glm02/projet-vide-cave/05_Notes/Obsidian/01 - Fonctionnement et architecture.md

---
tags: [vide-cave, architecture]
date: 2026-10-12
---
# Fonctionnement et architecture

Retour : [[00 - Accueil]] · Suite : [[04 - Anomalies et verifications]]

## Besoin prévu par les documents

La pré-étude prévoit la surveillance d'une pompe vide-cave, des informations de courant et de déphasage, un autotest tous les trois jours d'une durée maximale d'une minute, un affichage LCD et des alertes par LED/buzzer. Les seuils et les données de la plaque moteur sont à compléter.

## Chaîne prévue

```mermaid
flowchart LR
    AC[Alimentation secteur] --> P[Commutation de puissance par triac]
    P --> M[Moteur de pompe]
    M -. Courant à mesurer .-> I[Capteur de courant]
    I -. Signal analogique à relier .-> PIC[PIC16F1788]
    PIC -. Commande à raccorder .-> O[Optotriac]
    O --> P
    PIC --> LCD[LCD 162B]
    PIC -. Alarmes à terminer .-> A[LED et buzzer]
    V[Référence de tension ou zéro secteur à prévoir] -. Déphasage .-> PIC
```

Ce synoptique expose **l'intention**, pas une garantie que ces connexions sont présentes dans les fichiers actuels. Les pointillés signalent des interfaces à terminer ou à définir.

## Blocs présents dans le schéma G206

| Bloc | Rôle prévu | État à comprendre |
| --- | --- | --- |
| U1, PIC16F1788 | Acquisition, décision, affichage et commande | Firmware absent ; configuration de RA6/RA7 et des entrées analogiques à préciser |
| U3, symbole ACS756 | Mesure du courant moteur | Voie IP+/IP− non câblée ; sortie AN0 différente du net « capteur de courant » du PIC |
| TRIAC1, symbole FODM3011 / valeur « octo-triac » | Optotriac de commande vers la puissance | Référence réelle à choisir ; net de commande PIC différent de RB2 côté R7 ; empreinte actuellement hors carte |
| Triac_de_puissance1 | Commutation de la pompe | Référence fabricant et empreinte absentes ; pas encore sur le PCB |
| DS1, 162B | Affichage | Brochage particulier étudié ; ne pas lui appliquer automatiquement celui d'un LCD générique |
| BZ1 | Alerte sonore | Empreinte absente, polarité à clarifier |
| M1 | Moteur de la pompe, externe | Plaque moteur et raccordement à représenter ; n'a pas à être implanté comme un composant sur le PCB |
| Alimentation / reset / ICSP | Alimentation et programmation du PIC | Base nominale identifiée ; découplage physique à revoir |

La carte ne dispose pas de voie tension ou de détection du zéro permettant de produire la mesure de déphasage décrite dans la pré-étude. Le symbole AC n'est pas un bornier secteur phase/neutre complet.

## Limites de lecture

Les valeurs « 230 V », « environ 300 W » ou « 5 A » présentes dans la variante sont des hypothèses historiques, pas des mesures confirmées de cette pompe. Les choix de triac, optotriac, isolement et protections nécessitent les données réelles. Le [rapport d'analyse](../Analyse_G206_2026-10-12/RAPPORT_ANALYSE.md) distingue les constats de connexion, les vérifications sur documents et les hypothèses.

Anatomy sert à **visualiser et expliquer** ces blocs. Le schéma et le PCB KiCad restent les sources techniques de la réalisation.
