glm02/projet-vide-cave/05_Notes/PROJET VIDE CAVE/INFO 3.md

Les interruptions arrive au bout on valide un bit qui sappelle gie
