glm02/projet-vide-cave/01_Documents/Rapport/Rapport_conception_vide-cave.docx

UNIVERSITÉ CLAUDE BERNARD LYON 1

IUT Lyon 1 — Département Génie Électrique et Informatique Industrielle

BUT GEII 2ᵉ année — SAé 31/42 — Groupe 311

COMPTE RENDU DE CONCEPTION

Surveillance et protection d'une pompe de vide-cave par mesure du courant

Carte de commande à PIC16F1788 : capteur à effet Hall, optotriac et triac, LCD et alarmes


Maquette 3D de l'installation (Blender)

Réalisé par : [À compléter : Prénom NOM, Prénom NOM]

Enseignant encadrant : [À compléter : nom de l'enseignant]

Lieu : IUT Lyon 1 — département GEII

Année universitaire : 2026-2027 · Date de remise : [À compléter : date]

# Sommaire

Dans Word : clic droit sur le sommaire → Mettre à jour les champs → Mettre à jour toute la table.

## Liste des annexes

N° | Titre de l'annexe | Page
A1 | Schéma structurel complet (KiCad, format A3) | …
A2 | Typon / implantation du PCB (face B.Cu, straps F.Cu) | …
A3 | Extraits de fiches techniques : PIC16F1788, ACS756, MOC3041, triac, LCD 162B | …
A4 | Simulations LTspice : courant de la LED du MOC3041, filtre RC, gain du capteur | …
A5 | Planning (diagramme de Gantt) actualisé | …
A6 | Demande de composants (document séparé) | …

# 1. Introduction

Un vide-cave est une pompe qui évacue automatiquement l'eau d'infiltration d'une cave ou d'un sous-sol. Elle reste à l'arrêt la plupart du temps, parfois pendant plusieurs mois. Une panne (moteur bloqué ou grippé, pompe à sec, défaut électrique) peut donc rester invisible jusqu'au jour où la pompe est réellement nécessaire, c'est-à-dire au moment où sa défaillance a le plus de conséquences.

Le projet consiste à concevoir une carte électronique, associée à une pompe existante (moteur asynchrone monophasé 230 V), qui surveille automatiquement son bon fonctionnement. Le principe retenu est la mesure du courant absorbé par le moteur, image de sa charge mécanique :

- courant trop fort : moteur bloqué ou grippé → arrêt du moteur et alarme ;
- courant normal : la pompe évacue l'eau → fonctionnement autorisé ;
- courant trop faible : pompe à vide, sans eau → arrêt et information de l'utilisateur.

Le cahier des charges impose en outre un autotest automatique tous les 3 jours, d'une durée maximale d'une minute, pour vérifier la pompe même en l'absence d'eau, ainsi qu'une information locale par écran LCD, LED et buzzer. La pompe, le flotteur de niveau et la supervision à distance par Wi-Fi sont hors du périmètre de la carte.

Le synoptique simple ci-dessous présente le système dans son environnement. Le courant du moteur est mesuré par un capteur à effet Hall ; le microcontrôleur PIC16F1788 décide et commande le moteur à travers un optotriac et un triac de puissance ; l'utilisateur est informé par le LCD, la LED et le buzzer.

Secteur 230 V → Triac → Moteur de la pompe

↑ optotriac ↓ courant (capteur à effet Hall)

PIC16F1788 → LCD · LED · buzzer

Figure 1 — Synoptique simple du système (à remplacer par un dessin draw.io)

# 2. Présentation approfondie du projet

## 2.1 Évolution des choix depuis la pré-étude

La pré-étude laissait plusieurs choix ouverts. Le tableau suivant indique les solutions retenues pour la conception et leur justification.

Fonction | Pré-étude | Conception | Justification
Traitement | ESP32 pressenti | PIC16F1788 | Microcontrôleur étudié en cours (MPLAB X, MCC, XC8) ; ADC 12 bits, timers et UART suffisants ; le Wi-Fi devient une évolution
Coupure du moteur | Relais électromécanique | Optotriac MOC3041 + triac | Pas d'usure mécanique, commutation silencieuse au passage par zéro de la tension, isolement assuré par l'optotriac
Mesure du courant | Hall, transformateur ou shunt | ACS756 (effet Hall) | Isolement galvanique intrinsèque ; sortie en tension directement lisible par l'ADC
Mesure du déphasage | Prévue | [À compléter : décision] | Nécessite une voie de tension isolée (détecteur de passage par zéro), absente de la carte actuelle
Carte | À concevoir | Carte G206 adaptée | Réutilisation d'une carte existante : alimentation, PIC, LCD et ICSP déjà routés

Décision à rédiger — déphasage. Soit le déphasage est conservé : ajout d'une voie de passage par zéro de la tension isolée (type H11AA1) sur une entrée de capture du PIC, avec φ = 360° × Δt / T. Soit il est retiré du périmètre, parce que l'amplitude du courant suffit à distinguer le blocage et le fonctionnement à vide. Indiquer ici le choix et sa raison.

## 2.2 Notions nouvelles utilisées

### Capteur de courant à effet Hall

Le courant à mesurer traverse un conducteur placé près d'une cellule à effet Hall. Le champ magnétique créé par ce courant produit une tension proportionnelle, sans contact électrique entre le circuit de puissance et la sortie du capteur. L'ACS756 utilisé fournit une sortie centrée sur VCC/2 (2,5 V sous 5 V) à laquelle s'ajoute 20 mV par ampère.

### Optotriac à commutation au zéro de tension

Un optotriac associe une LED et un phototriac dans un même boîtier isolé. Quand la LED est alimentée, le phototriac déclenche la gâchette du triac de puissance. Le MOC3041 intègre un détecteur de passage par zéro : il ne s'amorce qu'au voisinage du zéro de la tension secteur, ce qui limite les parasites. Il ne permet pas la variation de puissance par angle de phase.

### Triac sur charge inductive

Le triac conduit dans les deux sens une fois amorcé et se bloque au passage par zéro du courant. Avec un moteur, charge inductive, le courant est en retard sur la tension : un réseau RC (snubber) limite la vitesse de remontée de la tension à ses bornes et évite les réamorçages intempestifs.

### Travail en points du CAN

Le PIC ne calcule nativement que sur 8 bits : il ne convertit pas la mesure en ampères pour décider. Il compare directement des valeurs en points du CAN (quantum q = 5 V / 4096 ≈ 1,22 mV) à des seuils exprimés eux aussi en points. Sur une période du secteur (20 ms), il garde la valeur maximale et la valeur minimale lues : leur différence est l'amplitude crête à crête du courant (détail au chapitre 6).

## 2.3 Synoptique détaillé

Le synoptique détaillé découpe la carte en six fonctions. Une barrière d'isolement sépare le côté secteur 230 V du côté basse tension 5 V : seuls le capteur à effet Hall et l'optotriac la traversent, sans liaison électrique. Les noms des signaux sont identiques dans le texte, le synoptique et le schéma structurel.

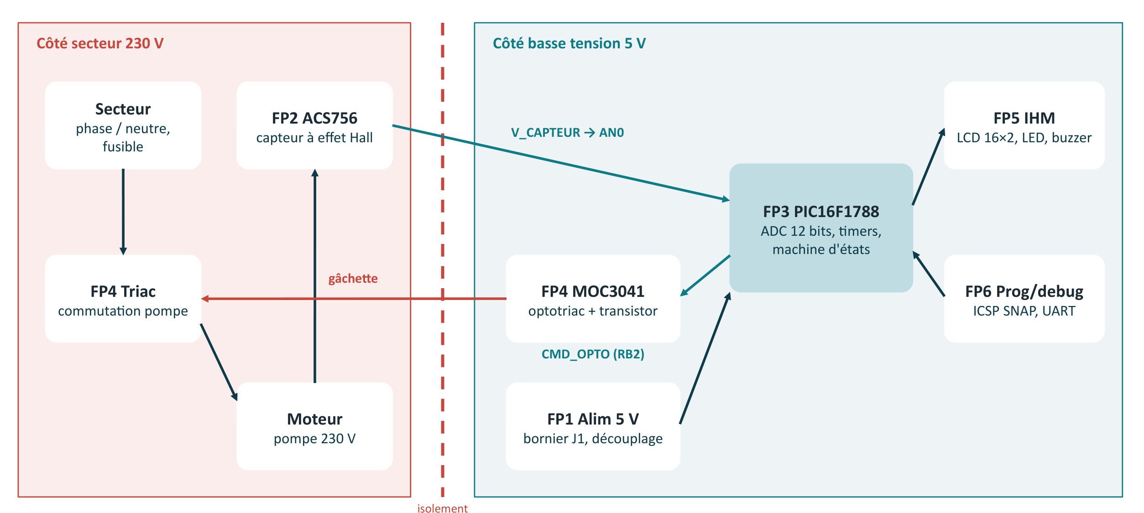
[picture p3: figure]

Figure 2 — Synoptique détaillé (à reprendre au format A4 avec cartouche : titre, auteurs, date)

Fonction | Composants | Entrées | Sorties
FP1 Alimentation | Bornier J1, C1 47 µF, C2 et C5 100 nF | 5V_EXT | +5V, GND
FP2 Mesure du courant | ACS756 (U3), filtre 1 kΩ / 10 nF | I_MOTEUR | V_CAPTEUR → AN0
FP3 Traitement | PIC16F1788 (U1), R12, SW4 | V_CAPTEUR | CMD_OPTO, bus LCD, LED, BUZ, TX
FP4 Commande de puissance | Transistor, MOC3041, triac, Rg, Rgk, snubber, fusible | CMD_OPTO | PHASE_MOTEUR
FP5 Interface utilisateur | LCD 162B (DS1), LED D4, buzzer BZ1 | Bus LCD, LED, BUZ | Affichage, signal lumineux et sonore
FP6 Programmation et débogage | J4 ICSP (MPLAB SNAP), J2 UART TTL | PGD, PGC, MCLR, RX | TX

# 3. Documents de gestion de projet

## 3.1 Organigramme des tâches

Chaque tâche élémentaire ci-dessous se retrouve dans le planning actualisé (annexe A5).

- 1. Gestion de projet
  - Planning, Kanban, dépôt Git commun, réunions
- 2. Étude
  - Cahier des charges et pré-étude
  - Relevé de la plaque de la pompe, choix des seuils Imin et Imax
  - Choix des composants : capteur, optotriac, triac, protections
- 3. Matériel
  - Correction du schéma structurel
  - Calculs et simulations LTspice
  - Routage du PCB, contrôle DRC
  - Fabrication, câblage
- 4. Logiciel
  - Configuration MCC (horloge, ADC, timer, ports)
  - Pilote LCD, mesure du courant efficace
  - Machine d'états, autotest, alarmes
- 5. Essais
  - Basse tension seule, puis charge résistive, puis pompe
- 6. Documents
  - Rapports de conception et de fabrication, soutenances

## 3.2 Planning actualisé

Proposition de répartition des séances restantes, à reporter dans le diagramme de Gantt. [À compléter : valider les dates avec le binôme]

Période | Tâches | Responsable
09/11 – 16/11 | Relevé de la pompe ; décisions (déphasage, capteur, triac) ; configuration MCC | …
16/11 – 30/11 | Correction du schéma ; pilote LCD et lecture de l'ADC | …
30/11 – 14/12 | Routage et DRC du PCB ; machine d'états et autotest | …
14/12 – 11/01 | Rédaction du rapport de conception ; demande de composants | …
S4 | Fabrication, essais, rapport de fabrication, soutenance finale | …

## 3.3 Retards et moyens de rattrapage

Retards constatés :

- la carte réutilisée contenait des liaisons rompues et des composants hérités, qu'il a fallu relever et nettoyer ;
- les caractéristiques de la pompe (courant nominal et de démarrage) ne sont pas encore connues ;
- le programmateur MPLAB SNAP a été bloqué lors d'une mise à jour automatique le 12 octobre.

Moyens de rattrapage, la date de fin restant inchangée :

- conduire en parallèle la partie matérielle (schéma, PCB) et la partie logicielle (MCC, programme) ;
- tester le programme sur la partie basse tension avant tout raccordement au secteur ;
- partager les fichiers par un dépôt Git commun, synchronisé en un double-clic.

# 4. Schéma structurel détaillé

Le schéma structurel complet figure en annexe A1. Il reprend la disposition et les noms du synoptique détaillé. Cette partie décrit chaque fonction et justifie le choix et la valeur des composants.

## 4.1 Corrections à apporter avant validation

Le contrôle de la carte adaptée a mis en évidence les points suivants, à corriger dans le schéma avant de le figer :

Point | Constat | Correction
Mesure → PIC | Sortie de U3 sur le net AN0, entrée du PIC sur « capteur de courant » | Un seul net V_CAPTEUR
Commande → optotriac | Sortie RB2 et résistance R7 sur deux nets différents | Un seul net CMD_OPTO
Primaire du capteur | IP+ et IP− non câblés | Insérer le capteur en série avec le moteur
Optotriac | FODM3011, 4 broches, tenue 250 V | MOC3041, 6 broches, tenue 400 V : symbole et empreinte
Raccordement secteur | Symbole AC à une broche ; R4 en série avec le moteur | Bornier phase/neutre, fusible, bornier moteur ; supprimer R4
R3, R4, R7 | Valeur « R », sans empreinte | Valeurs calculées en 4.5
Buzzer BZ1 | Borne + reliée à GND | Inverser, choisir la référence
Découplage | Pas de 100 nF sur U3 ; C2 à 33 mm du PIC | Ajouter et rapprocher
Mise au point | Pas de point de test | Points de test +5V, GND, V_CAPTEUR, CMD_OPTO

## 4.2 FP1 — Alimentation

La carte reçoit 5 V continus par le bornier J1. C1 = 47 µF constitue la réserve d'énergie ; C2 = 100 nF découple le PIC et C5 = 100 nF le LCD. Aucun régulateur n'est présent : la source 5 V doit être isolée du secteur.

[À compléter : préciser la source 5 V : bloc externe ou module secteur/5 V isolé sur la carte]

## 4.3 FP2 — Mesure du courant

Le courant du moteur traverse le primaire de l'ACS756 (broches IP+ et IP−). Sa sortie VIOUT vaut :

V_CAPTEUR = 2,5 V + 0,020 × i(t)

Un filtre passe-bas R = 1 kΩ, C = 10 nF limite le bruit à l'entrée de l'ADC. Sa fréquence de coupure fc = 1 / (2π × 1 kΩ × 10 nF) ≈ 15,9 kHz est très au-dessus de 50 Hz : le signal utile n'est ni atténué ni déphasé de façon notable (−0,18° à 50 Hz, simulation LTspice en annexe A4).

CAN 12 bits, VREF+ = 5 V, VREF− = 0 V : quantum q = 5 V / 4096 ≈ 1,22 mV, soit 1,22 mV / 20 mV/A = 61 mA par point. RA0 est configurée en entrée (TRISA0 = 1) et en analogique (ANSELA0 = 1). La tension au repos (2,5 V, soit environ 2048 points) est vérifiée moteur arrêté, comme pour la calibration du joystick en TP.

Limite. Pour une pompe d'environ 300 W (300 W / 230 V ≈ 1,3 A en négligeant le facteur de puissance ; le courant réel est plus élevé, valeur à remplacer par la plaque), la variante ±100 A n'utilise qu'environ 21 pas de l'ADC. Deux solutions : un capteur de plus petit calibre (par exemple ACS712-5A, 185 mV/A), ou une amplification ×5 centrée sur 2,5 V (12 mA par pas) en conservant la mesure du courant de démarrage. [À compléter : solution retenue]

## 4.4 FP3 — Traitement : PIC16F1788

Le PIC est alimenté en 5 V (VDD broche 20, VSS broches 8 et 19). R12 = 10 kΩ rappelle MCLR au +5 V ; le bouton SW4 réalise le reset. L'oscillateur interne est utilisé, ce qui libère RA6 et RA7 pour le LCD (VCAPEN désactivé). Chaque broche est configurée une seule fois au démarrage : ANSEL = 0 (numérique) sauf RA0, TRIS = 0 pour les sorties. Les broches sont nommées dans MCC (CAPTEUR, LED_DEFAUT, BUZZER, CMD_OPTO), ce qui génère les macros utilisées dans le programme.

Fonction | Port | Broche DIP28
Mesure du courant (ADC) | RA0 / AN0 | 2
LCD RS, RW, E | RA1, RA2, RA3 | 3, 4, 5
LCD D4, D5, D6, D7 | RA4, RA5, RA7, RA6 | 6, 7, 9, 10
LED D4 | RB0 | 21
Buzzer | RB1 | 22
Commande de l'optotriac | RB2 | 23
UART TX, RX | RC6, RC7 | 17, 18
Programmation ICSP CLK, DAT | RB6, RB7 | 27, 28
Reset | MCLR | 1

## 4.5 FP4 — Commande de puissance

### Commande de la LED de l'optotriac

La LED du MOC3041 est commandée par un transistor NPN plutôt que directement par le PIC : il fournit le courant nécessaire et, grâce à la résistance de rappel base-émetteur, garde l'optotriac bloqué pendant le reset du PIC.

Le MOC3041 garantit l'amorçage pour un courant de LED d'au plus 15 mA (IFT max). Le calcul est fait dans le cas défavorable : alimentation 5 V − 5 %, chute de la LED 1,5 V, transistor saturé 0,2 V, résistance + 5 % :

I_min = (4,75 − 1,5 − 0,2) / (1,05 × R_LED)

R_LED | I_min simulé | I nominal | Conclusion
150 Ω | 19,4 mA | 23,7 mA | Retenue : marge au-dessus de 15 mA
180 Ω | 16,1 mA | 19,7 mA | Marge faible
220 Ω | 13,2 mA | 16,1 mA | Amorçage non garanti
270 Ω | 10,8 mA | 13,2 mA | Amorçage non garanti (ancienne valeur)

R_LED = 150 Ω, ¼ W (puissance maximale calculée 0,115 W). Base du transistor : 1 kΩ en série, 100 kΩ de rappel ; avec VOH = 4 V et VBE = 0,9 V, I_B ≈ 2,95 mA, suffisant pour saturer un transistor à 30 mA. Ces valeurs sont à vérifier avec la fiche du transistor retenu.

### Commande du triac

Valeurs de départ issues du schéma d'application du fabricant pour 240 V, à valider avec le triac réel : Rg = 360 Ω entre A2 et la sortie du MOC3041, Rgk = 330 Ω entre gâchette et A1, snubber 39 Ω + 10 nF (classe X) aux bornes du triac. Le courant de gâchette vaut approximativement :

I_G ≈ (|V_A2-A1| − V_TM − V_GT) / Rg − V_GT / Rgk

Topologie : phase → fusible → IP+ / IP− du capteur → moteur → A2 du triac ; A1 → neutre. [À compléter : référence du triac (courant, IGT, boîtier) et calcul du dissipateur]

### Sécurité électrique

La tension secteur atteint 325 V crête (358 V à 253 V efficaces). Le MOC3041 tient 400 V en blocage, d'où une marge limitée à protéger (fusible, limitation des surtensions). Les masses GND et PIC ne sont jamais reliées au neutre ou à A1. Sur le PCB, les pistes secteur sont séparées de la partie 5 V par une distance d'isolement de plusieurs millimètres, à déterminer selon la norme : la règle générale de 0,5 mm du projet ne convient pas au secteur.

## 4.6 FP5 — Interface utilisateur

Le LCD 162B (DS1) est commandé en mode 4 bits (DB4 à DB7) ; DB0 à DB3 ne sont pas connectés. Son brochage particulier (1 LEDA, 2 LEDK, 3 VSS, 4 VDD, 5 VO, 6 RS, 7 RW, 8 E) a été vérifié sur la documentation du fabricant.

- Contraste : pont R11 = 56 kΩ, R13 = 1,5 kΩ → VO = 5 × 1,5 / 57,5 ≈ 0,13 V.
- Rétroéclairage : R14 = 270 Ω → I = (5 − 3,2) / 270 ≈ 6,7 mA.
- LED D4 : R10 = 270 Ω → I = (5 − 2) / 270 ≈ 11 mA, compatible avec une sortie du PIC (25 mA max).
- Buzzer BZ1 : commandé par RB1 à travers R9 = 270 Ω. [À compléter : référence, courant, polarité corrigée, transistor éventuel]

## 4.7 FP6 — Programmation et débogage

Le connecteur J4 reçoit le programmateur MPLAB SNAP : 1 MCLR/VPP, 2 +5 V, 3 GND, 4 ICSPDAT (RB7), 5 ICSPCLK (RB6). Le SNAP n'alimente pas la carte : le 5 V est fourni par J1. Le connecteur J2 donne accès à la liaison série TTL (TX broche 5, RX broche 4, GND broche 1) pour afficher les mesures brutes pendant la mise au point.

## 4.8 Circuit imprimé

La carte mesure 90 × 80 mm. Le routage est réalisé côté cuivre B.Cu ; deux straps filaires (GND 14 mm et MCLR 10 mm) évitent un circuit double face. Les 21 empreintes de l'ancienne carte absentes du schéma ont été retirées. Règles : piste 0,6 mm (0,7 mm pour +5V et GND), isolement 0,5 mm, plan de masse sur B.Cu.

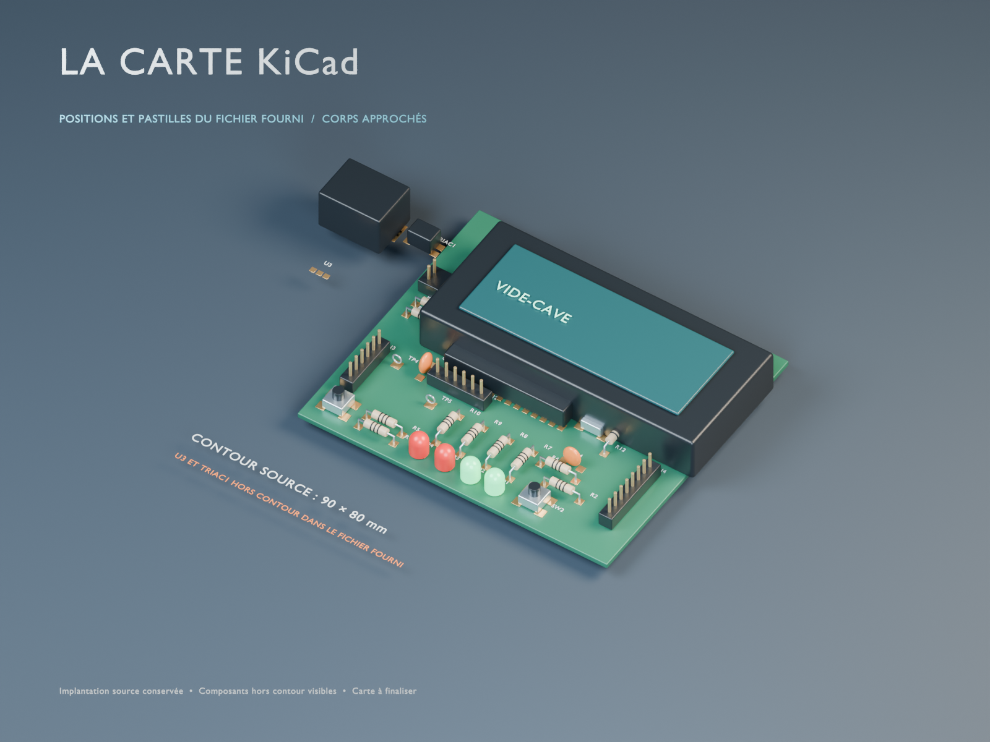
[picture p4: figure]

Figure 3 — Rendu 3D de la carte (implantation actuelle, avant ajout de la partie puissance)

# 5. Nomenclature

Les composants sont classés par famille. Les lignes « ajout » proviennent des corrections du chapitre 4 ; leurs repères sont à attribuer dans KiCad. Les tensions de service marquées « … » sont à compléter.

## Résistances (¼ W, 5 %, sauf mention)

Repère | Valeur | Rôle | Empreinte
R7 | 150 Ω | LED du MOC3041 | Axial DIN0207 P10,16
R3 | 360 Ω, ½ W | Rg, gâchette du triac (supporte les impulsions) | Axial DIN0207 P10,16
R4 | — | À supprimer (en série avec le moteur) | —
R9, R10, R14 | 270 Ω | Buzzer, LED D4, rétroéclairage LCD | Axial DIN0207 P10,16
R11 | 56 kΩ | Contraste LCD | Axial DIN0207 P10,16
R12 | 10 kΩ | Rappel de MCLR | Axial DIN0207 P10,16
R13 | 1,5 kΩ | Contraste LCD | Axial DIN0207 P10,16
R_B (ajout) | 1 kΩ | Base du transistor | Axial DIN0207 P10,16
R_BE (ajout) | 100 kΩ | Rappel base-émetteur | Axial DIN0207 P10,16
R_GK (ajout) | 330 Ω | Gâchette – A1 du triac | Axial DIN0207 P10,16
R_SN (ajout) | 39 Ω, 1 W | Snubber | à définir
R_F (ajout) | 1 kΩ | Filtre d'entrée ADC | Axial DIN0207 P10,16

## Condensateurs

Repère | Valeur | Tension | Type | Empreinte
C1 | 47 µF | … V | Électrolytique radial | CP_Radial_D6.3mm_P2.50mm
C2, C5 | 100 nF | … V | Céramique disque | Disc_D4.7mm_W2.5mm_P5.00mm
C_U3 (ajout) | 100 nF | … V | Céramique, découplage ACS756 | Disc_D4.7mm_W2.5mm_P5.00mm
C_F (ajout) | 10 nF | … V | Céramique, filtre ADC | Disc_D4.7mm_W2.5mm_P5.00mm
C_SN (ajout) | 10 nF | 275 V AC | Polypropylène classe X2, snubber | à définir

## Semi-conducteurs et circuits intégrés

Repère | Désignation | Boîtier / empreinte
U1 | PIC16F1788-I/SP, microcontrôleur | DIP-28 W7,62 mm
U3 | ACS756 (calibre à confirmer), capteur à effet Hall | Allegro CB-PFF
TRIAC1 | MOC3041, optotriac zéro-crossing (remplace le FODM3011) | DIP-6 W7,62 mm
Triac_de_puissance1 | Triac 600 V, référence à choisir | TO-220 + dissipateur
Q1 (ajout) | Transistor NPN petits signaux, référence à choisir | TO-92
D4 | LED rouge 5 mm | LED_D5.0mm

## Connectique, affichage et divers

Repère | Désignation | Empreinte
J1 | Bornier 2 points, alimentation 5 V | Bornier 1×02 P5 mm
J2 | Barrette 6 broches, liaison série TTL | PinHeader 1×06 P2,54 mm
J4 | Barrette 8 broches, programmation ICSP (SNAP) | PicKit_4_Snap 1×08 P2,54 mm
J_SECT (ajout) | Bornier secteur phase / neutre | Bornier 1×02 P5 mm, 250 V
J_MOT (ajout) | Bornier moteur | Bornier 1×02 P5 mm, 250 V
F1 (ajout) | Fusible et porte-fusible, calibre selon la pompe | à définir
DS1 | Afficheur LCD 16×2 Displaytech 162B | 162B
BZ1 | Buzzer, référence à choisir | à définir
SW4 | Bouton poussoir Omron B3F-1000 (reset) | SW_TH_Tactile_Omron_B3F-10xx
M1 | Moteur de la pompe (hors carte) | —
— | Boîtier étanche IP adapté à une cave | —

Demande de composants. Document séparé (annexe A6), sans repères : désignation précise, quantité, fabricant, distributeur, référence distributeur, prix et délai. Classement : résistances puis condensateurs par valeurs croissantes, semi-conducteurs, circuits intégrés, connectique.

# 6. Organigrammes des programmes

Le programme est écrit en C sous MPLAB X avec le compilateur XC8. La configuration du PIC (horloge, broches, CAN, Timer2) est faite dans MCC, qui génère les fonctions d'initialisation et les macros des broches. Le code généré par MCC n'est pas modifié : nos fonctions sont enregistrées auprès de lui.

## 6.1 Configuration faite dans MCC

Élément | Réglage | Justification
Horloge | Oscillateur interne, FOSC = 4 MHz | Libère RA6 et RA7 pour le LCD ; TCY = 4 / FOSC = 1 µs
RA0 / AN0 | Entrée (TRIS = 1), analogique (ANSEL = 1), nom CAPTEUR | Tension du capteur de courant
RA1 à RA7 | Sorties numériques (TRIS = 0, ANSEL = 0) | Bus du LCD en mode 4 bits
RB0 | Sortie numérique, nom LED_DEFAUT | LED D4
RB1 | Sortie numérique, nom BUZZER | Buzzer BZ1
RB2 | Sortie numérique, nom CMD_OPTO, état initial 0 | Moteur à l'arrêt dès la mise sous tension
CAN | 12 bits, VREF+ = VDD = 5 V, VREF− = VSS, TAD > 1 µs, résultat aligné à droite | q = 5 V / 4096 ≈ 1,22 mV, soit 61 mA par point (20 mV/A)
Timer2 | Période 10 ms, interruption autorisée | Base de temps de l'autotest et de la mesure

Calcul du Timer2 : 10 ms = 10 000 TCY = prescaler 16 × (PR2 + 1 = 125) × postscaler 5, donc PR2 = 124. Les broches nommées dans MCC donnent des macros comme CMD_OPTO_SetHigh() ou LED_DEFAUT_SetLow().

## 6.2 Machine à états

Le comportement est séquentiel : il est codé par une machine à états, une variable etat et un switch(etat) avec un case par état.

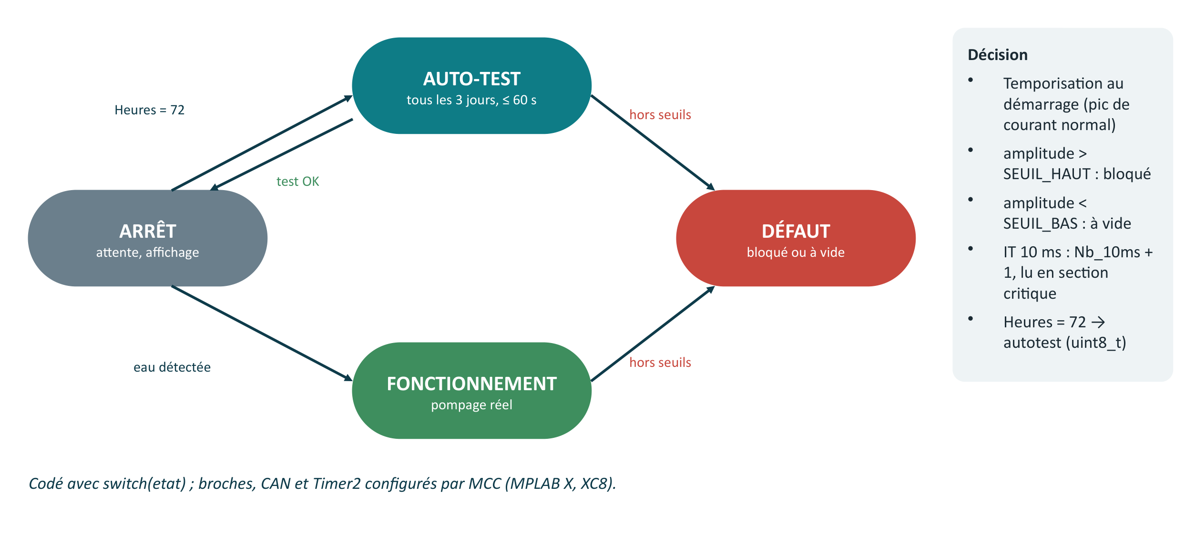
[picture p5: figure]

Figure 4 — Machine à états du programme

État | Ce que fait le PIC | Transition
ARRET | CMD_OPTO à 0, affichage de l'état | Heures = 72 → AUTO_TEST ; présence d'eau → FONCTIONNEMENT
AUTO_TEST | CMD_OPTO à 1 pendant 60 s au plus, mesure de l'amplitude | 60 s sans défaut → ARRET ; amplitude hors seuils → DEFAUT
FONCTIONNEMENT | CMD_OPTO à 1, mesure de l'amplitude | Fin du pompage → ARRET ; amplitude hors seuils → DEFAUT
DEFAUT | CMD_OPTO à 0, LED et buzzer, message selon la cause | Acquittement → ARRET

## 6.3 Organigramme du programme principal

1. SYSTEM_Initialize() : configuration des broches (ANSEL, TRIS), du CAN et du Timer2, faite une seule fois avant le while(1).
2. Initialisation du LCD, affichage de « ARRET ».
3. Enregistrement de la fonction IT_Timer2 auprès du Timer2.
4. Autorisation des interruptions en dernier : GIE, et PEIE car le Timer2 est une interruption interne.
5. Boucle while(1) qui ne se termine jamais : recopier Nb_10ms en section critique et mettre à jour la base de temps avec cette copie ; puis exécuter le case de l'état courant ; rafraîchir le LCD seulement si l'état ou la mesure a changé (évite le scintillement).

## 6.4 Base de temps et interruption

La routine d'interruption est la plus courte possible : elle ajoute seulement 1 à Nb_10ms. Un simple flag ne suffirait pas : si le main est occupé pendant les 20 ms de la mesure, deux interruptions peuvent arriver, et un flag remis à 1 deux fois n'en mémorise qu'une ; le comptage des trois jours prendrait du retard. Avec un compteur, aucun pas n'est perdu. Nb_10ms est partagée entre l'IT et le main : elle est globale et volatile. Le main la lit puis la remet à zéro : on coupe les interruptions pendant ce court instant (section critique), sinon une IT tombant entre la lecture et la remise à zéro serait perdue.

1. IT_Timer2 (toutes les 10 ms) : Nb_10ms = Nb_10ms + 1.
2. Dans le main, en section critique : copie = Nb_10ms puis Nb_10ms = 0. Ensuite Compteur_10ms augmente de copie ; à 100 ou plus, on retire 100 et Secondes augmente de 1.
3. Secondes passe de 0 à 59, puis Minutes de 0 à 59, puis Heures de 0 à 72 : tous des uint8_t, le plus petit type suffisant.
4. Heures = 72 (3 jours) dans l'état ARRET : passage en AUTO_TEST et remise à zéro des compteurs.
5. En AUTO_TEST, Secondes sert aussi à limiter le test à 60 s.

Un __delay_ms() ne convient pas ici : pendant le délai le PIC ne fait rien d'autre, il ne pourrait plus surveiller le moteur.

## 6.5 Mesure du courant en points du CAN

Le PIC travaille en points du CAN, sans calcul flottant. La fonction Mesure_Amplitude() lit AN0 pendant une période du secteur (20 ms) et garde la plus grande et la plus petite valeur. Leur différence donne l'amplitude crête à crête du courant, sans avoir à connaître l'offset de 2,5 V.

1. maxi = 0, mini = 4095.
2. Pendant 20 ms : lancer une conversion de AN0, attendre la fin, lire le résultat ; s'il est plus grand que maxi, le garder dans maxi ; s'il est plus petit que mini, le garder dans mini.
3. Retourner amplitude = maxi − mini (uint16_t).

Pour un courant sinusoïdal, amplitude (points) = 2√2 × I_eff × 20 mV/A / 1,22 mV, soit I_eff ≈ 21,6 mA par point. L'affichage en milliampères se fait en entiers : I_mA = amplitude × 216 / 10, calcul fait sur 32 bits (unsigned long) pour ne pas dépasser.

## 6.6 Décision

1. Après la mise en marche, ne rien comparer pendant la temporisation de démarrage : le pic de courant est normal.
2. amplitude > SEUIL_HAUT : CMD_OPTO à 0, état DEFAUT, message « MOTEUR BLOQUE ».
3. amplitude < SEUIL_BAS : CMD_OPTO à 0, état DEFAUT, message « POMPE A VIDE », signal différent.
4. Sinon, le fonctionnement continue. [À compléter : SEUIL_HAUT, SEUIL_BAS en points du CAN et durée de la temporisation, après relevé de la pompe]

## 6.7 Squelette du programme

Squelette à compléter au fil des essais, une fonctionnalité à la fois. Les noms des fonctions générées par MCC sont à vérifier dans les fichiers .h produits pour le PIC16F1788.

#include "mcc_generated_files/mcc.h" // en-tête généré par MCC (nom à vérifier)

#include <stdio.h>

// états de la machine à états

#define ARRET 0

#define AUTO_TEST 1

#define FONCTIONNEMENT 2

#define DEFAUT 3

// seuils en points du CAN (q = 5 V / 4096 = 1,22 mV)

#define SEUIL_HAUT 0 // à compléter après relevé de la pompe

#define SEUIL_BAS 0 // à compléter après relevé de la pompe

volatile uint8_t Nb_10ms = 0; // pas de 10 ms comptés par l'IT : globale et volatile

void IT_Timer2(void);

uint16_t Mesure_Amplitude(void);

void main(void)

{

uint8_t etat = ARRET;

uint8_t copie = 0;

uint8_t Compteur_10ms = 0;

uint8_t Secondes = 0;

uint8_t Minutes = 0;

uint8_t Heures = 0;

uint16_t amplitude = 0;

SYSTEM_Initialize(); // broches, CAN, Timer2 (MCC)

TMR2_SetInterruptHandler(IT_Timer2); // enregistrement AVANT d'autoriser les IT

INTERRUPT_GlobalInterruptEnable(); // GIE = 1

INTERRUPT_PeripheralInterruptEnable(); // PEIE = 1 : Timer2 est une IT interne

while(1) // ne se termine jamais

{

INTERRUPT_GlobalInterruptDisable(); // section critique (GIE = 0)

copie = Nb_10ms; // pas arrivés depuis le dernier passage

Nb_10ms = 0;

INTERRUPT_GlobalInterruptEnable(); // GIE = 1

Compteur_10ms = Compteur_10ms + copie;

if(Compteur_10ms >= 100) // 100 x 10 ms = 1 s

{

Compteur_10ms = Compteur_10ms - 100;

Secondes = Secondes + 1;

// Minutes et Heures : à compléter

}

switch(etat)

{

case ARRET:

CMD_OPTO_SetLow(); // moteur à l'arrêt

// si Heures == 72 : etat = AUTO_TEST

break;

case AUTO_TEST:

CMD_OPTO_SetHigh();

// après la temporisation : amplitude = Mesure_Amplitude();

// comparer à SEUIL_HAUT et SEUIL_BAS, arrêt au bout de 60 s

break;

case FONCTIONNEMENT:

// à compléter

break;

case DEFAUT:

CMD_OPTO_SetLow();

LED_DEFAUT_SetHigh();

// message LCD selon la cause, buzzer

break;

}

}

}

void IT_Timer2(void) // appelée toutes les 10 ms

{

Nb_10ms = Nb_10ms + 1; // traitement court : on compte, le main fait le reste

}

[À compléter : dessiner les organigrammes 6.3 à 6.6 sous draw.io avec les symboles normalisés]

# 7. Conclusion

À ce stade de la conception, l'architecture de la carte est définie : mesure du courant par effet Hall, traitement par PIC16F1788, commande du moteur par optotriac et triac, interface par LCD, LED et buzzer. Les principaux composants ont été choisis et dimensionnés dans le cas le plus défavorable, en s'appuyant sur des simulations LTspice.

La carte existante a été adaptée et nettoyée ; son contrôle a fait apparaître des liaisons à corriger, listées au chapitre 4. La configuration du microcontrôleur est prise en charge par MCC et la structure du programme est définie par une machine à quatre états.

Les principales difficultés ont été la reprise d'une carte conçue pour un autre usage, l'absence des données de la pompe et le blocage du programmateur lors d'une mise à jour. Le planning a été actualisé en conséquence, sans modifier la date de fin.

Reste à faire : relever la plaque de la pompe et fixer les seuils ; trancher la question du déphasage et du calibre du capteur ; corriger le schéma ; router la partie puissance ; écrire et tester le programme ; établir la demande de composants.

[À compléter : avancement chiffré par bloc et part de travail de chacun]

# Annexes

Chaque annexe est citée dans le rapport. Insérer ici, dans l'ordre :

- A1 — Schéma structurel complet (export PDF de KiCad, format A3, avec cartouche)
- A2 — Typon et implantation du PCB
- A3 — Extraits de fiches techniques : PIC16F1788, ACS756, MOC3041, triac retenu, LCD 162B
- A4 — Simulations LTspice (dossier 05_Notes/Etude_MOC3041)
- A5 — Diagramme de Gantt actualisé
- A6 — Demande de composants

Compte rendu de conception — Vide-cave — Groupe 311
