glm02/projet-vide-cave/01_Documents/Presentation/Soutenance_vide-cave.pptx

## Surveillance d'une pompe de vide-cave

Connaître l'état du moteur en mesurant son courant : carte à PIC16F1788, triac, capteur à effet Hall

[Prénom NOM] · [Prénom NOM]
BUT GEII 2 — SAé 31/42 — Groupe 311
Encadrant : [Nom de l'enseignant]
IUT Lyon 1 · Département GEII · 2026-2027

Maquette 3D : pompe dans son puisard et coffret de commande

Maquette 3D de l'installation (Blender)

Notes: 30 s. Bonjour, nous sommes [prénom] et [prénom]. Notre projet, c'est une carte qui surveille la pompe d'un vide-cave en mesurant le courant de son moteur. C'est une soutenance intermédiaire : je vais présenter le besoin, les composants qu'on a choisis, le code qu'on a déjà écrit, et ce qu'il nous reste à faire.

## Une pompe en cave peut tomber en panne sans qu'on le voie

1

La pompe vide l'eau de la cave, puis reste à l'arrêt parfois pendant des mois.

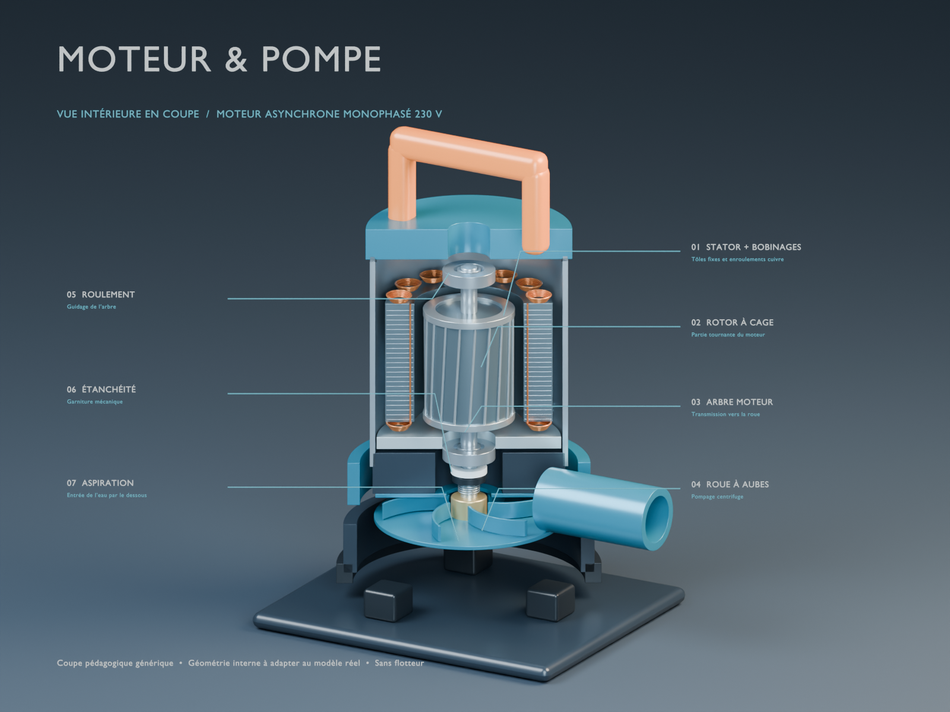
[picture p8: figure]
Vue intérieure du moteur de la pompe

Moteur asynchrone monophasé 230 V (maquette 3D)

2

Elle est dans une cave, pas facile d'accès : personne ne va vérifier qu'elle marche.

3

Si elle est bloquée, on ne le découvre que le jour de l'inondation.

Objectif : connaître l'état du moteur sans descendre à la cave, juste en mesurant son courant.

Notes: 1 min. Le problème : la pompe est dans une cave, on ne va pas vérifier tous les jours si elle marche. Si elle est bloquée, on s'en rend compte quand la cave est inondée. Le but de notre système, c'est de connaître l'état du moteur sans avoir besoin de descendre : passant, bloqué ou à vide. C'est prévu pour un usage domestique, une maison individuelle.

## Le courant nous dit dans quel état est le moteur

Courant trop fort

Le moteur force : il est bloqué

On coupe le moteur et on alerte

Courant normal

La pompe vide l'eau

On laisse tourner

Courant trop faible

La pompe tourne à vide, sans eau

On coupe le moteur

Le piège : le démarrage. Un moteur appelle beaucoup de courant quand il démarre, c'est normal. Donc on tolère ce pic quelques secondes : si le courant redescend, tout va bien ; s'il reste fort, le moteur est bloqué.

3 jours

la pompe se met en marche toute seule

230 V

secteur, à isoler de la partie 5 V

LCD · LED

pour afficher l'état du moteur

Notes: 1 min. Tout repose sur une idée : le courant dépend de ce que le moteur doit entraîner. S'il est bloqué, il force et le courant monte. S'il tourne à vide, il n'a rien à pousser et le courant baisse. Le piège, c'est le démarrage : il y a un pic de courant qui est normal, par exemple 3 A puis ça redescend vers 1 A (ordre de grandeur, on doit encore le mesurer sur la vraie pompe). Donc on laisse quelques secondes avant de décider.

## Trois composants isolent le 230 V de la partie 5 V

Côté basse tension 5 V

Côté secteur 230 V

Moteur
pompe 230 V

BTA12
triac : marche ou arrêt

Secteur
phase et neutre

ACS756
capteur de courant

AN0 (RA0)

LCD · LED
affiche l'état

PIC16F1788
lit le courant, décide, commande

MOC3023
optotriac

gâchette

RB2

Programmation
SNAP, UART

passage par zéro

6N136
optocoupleur

Notes: 1 min. À gauche le secteur et la pompe, à droite le 5 V avec le PIC. Il n'y a aucun fil entre les deux : les trois composants au milieu font le lien sans contact électrique. L'ACS756 mesure le courant du moteur par effet Hall et envoie une tension sur AN0. Le PIC décide et commande par RB2 l'optotriac MOC3023, qui déclenche la gâchette du triac BTA12. Le 6N136 sert à détecter quand la tension passe par zéro, pour déclencher les mesures de courant au bon moment.

## Ce qui a changé depuis la pré-étude, et pourquoi

Fonction | Pré-étude | Aujourd'hui | Pourquoi
Couper le moteur | Relais | Triac BTA12 + optotriac MOC3023 | Pas de pièce qui s'use, le PIC le commande à travers une isolation
Microcontrôleur | ESP32 | PIC16F1788 | Celui de la carte SAE22 qu'on connaît. L'ESP32 reste une évolution pour envoyer une alerte par mail
Mesure au bon moment | Pas prévu | Optocoupleur 6N136 | Repérer le passage par zéro pour déclencher les mesures et, à terme, mesurer le déphasage
Niveau d'eau | Flotteur | Pas de flotteur | La pompe démarre tous les 3 jours : le courant dit s'il y a de l'eau
Carte | À concevoir | Carte SAE22 adaptée | On garde PIC, liaison série, LED, LCD ; on enlève la liaison avec le hacheur

Notes: 1 min. Au départ on devait partir sur un relais, finalement on est passé au triac. On a ajouté l'optocoupleur 6N136 pour savoir à quel moment la tension passe par zéro, et déclencher les mesures de courant au bon endroit. Et on repart de la carte de la SAE22 du robot, qu'on modifie : on garde ce qui nous sert, on enlève la liaison avec le hacheur.

## Les composants de la partie mesure et puissance

Capteur de courant
ACS756xCB-100B-PFF · Allegro
Transforme le courant du moteur en tension, par effet Hall, sans contact avec le secteur.
2,5 V à 0 A, puis 20 mV par ampère

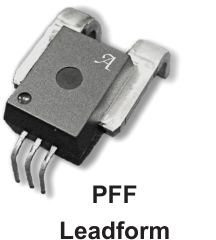
[picture p9: figure]
Capteur de courant

Triac
BTA12 · STMicroelectronics · TO-220 isolé
L'interrupteur de puissance : laisse passer ou non le 230 V vers la pompe.
12 A efficaces au maximum

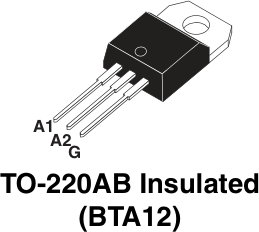
[picture p10: figure]
Triac

Optotriac
MOC3023M · Fairchild / onsemi · DIP-6
Le PIC allume une LED, la lumière déclenche la gâchette du triac. Aucun fil entre les deux.
S'amorce à 5 mA max, tient 400 V crête

Optocoupleur
6N136 · DIP-8
Donne au PIC l'image du secteur, isolée, pour repérer le passage par zéro de la tension.
T = 20 ms, deux zéros par période

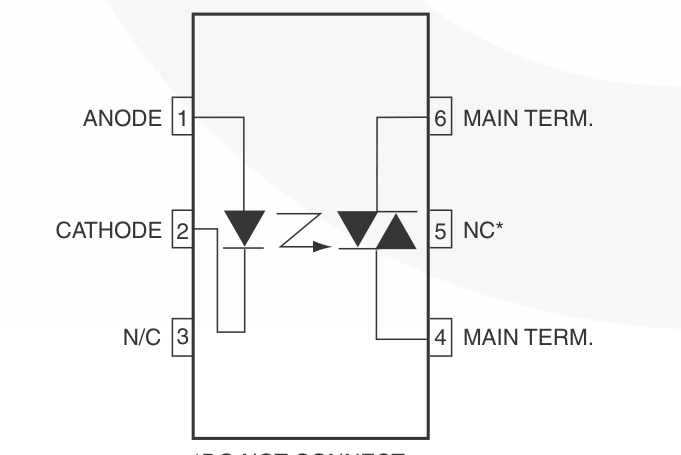
[picture p11: figure]
Optotriac
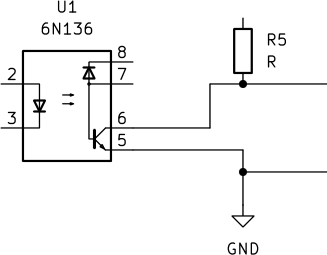
[picture p12: figure]
Optocoupleur

Notes: 1 min. Quatre composants clés. Le capteur Allegro transforme le courant en tension : 2,5 V au repos plus 20 mV par ampère. Le triac BTA12, c'est l'interrupteur de puissance. L'optotriac MOC3023 le commande : une LED côté PIC, un phototriac côté secteur. Il lui faut 5 mA au maximum pour s'amorcer. Le 6N136 sert à détecter le passage par zéro de la tension. La plupart de ces composants nous ont été fournis à l'IUT.

## Le microcontrôleur, l'afficheur et la nomenclature

Repère | Valeur | Rôle
C1 | 47 µF | Réserve d'énergie sur le 5 V
C5 | 100 nF | Découplage du LCD
R11, R13 | 56 kΩ, 1,5 kΩ | Contraste du LCD
R14 | 270 Ω | Rétroéclairage du LCD
R12 | 10 kΩ | Rappel de MCLR au 5 V
J1, J2, J4 | Connecteurs | Alimentation, série, programmation
R7 | ≈ 330 Ω à valider | LED de l'optotriac (calcul page suivante)
R3, R4 | À fixer | Commande de la gâchette du triac
R1, R2, R5, C2 | À fixer | Détection du zéro (6N136)

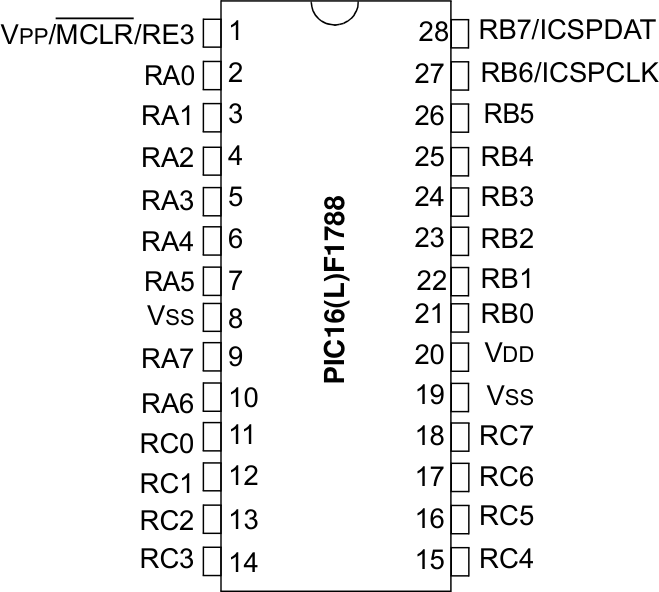
[picture p13: figure]
Brochage du PIC16F1788

PIC16F1788
Microchip · DIP-28
CAN 12 bits, sorties, UART.
RA0 : capteur · RB2 : optotriac · RB0 : LED

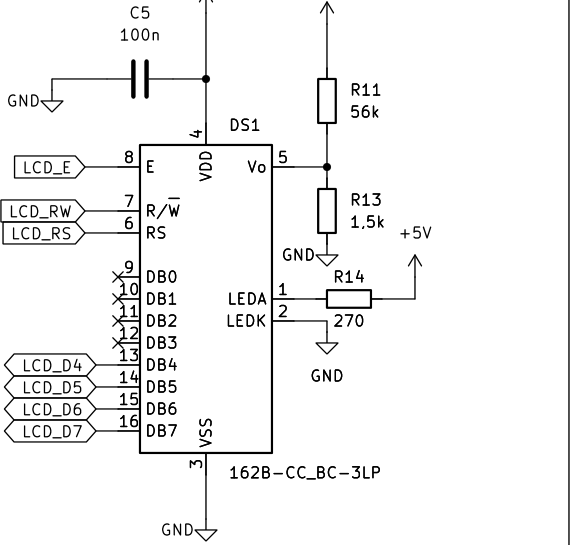
[picture p14: figure]
Schéma du LCD en mode 4 bits

Afficheur LCD
Displaytech 162B · 2 × 16
Affiche l'état du moteur.
Mode 4 bits : RA1 à RA7

Notes: 45 s. Le PIC16F1788, c'est celui de la carte SAE22. J'ai choisi les broches dans la documentation : RA0 pour l'entrée analogique, RB2 pour commander l'optotriac. Le LCD est en mode 4 bits pour économiser des broches. En rouge, les valeurs de résistances qu'il nous reste à fixer avant d'imprimer la carte : je le dis clairement.

## Le schéma de la partie puissance et de la détection du zéro

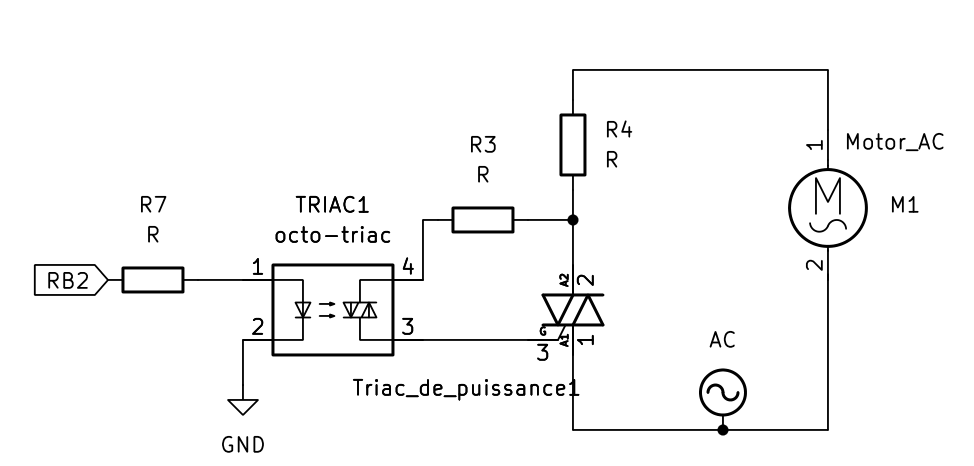
[picture p15: figure]
Schéma KiCad : optotriac, triac et moteur
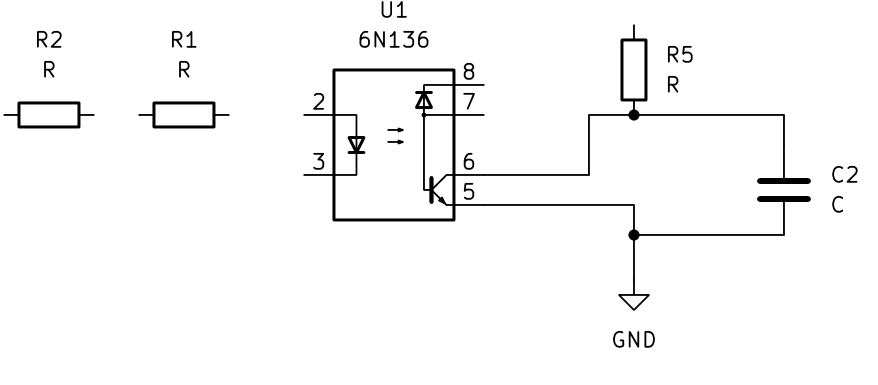
[picture p16: figure]
Schéma KiCad : optocoupleur 6N136

Version de travail KiCad du 2 novembre : le symbole « octo-triac » est à remplacer par le MOC3023 (6 broches)

Calcul de R7, la LED de l'optotriac
Pire cas : R7 = (5 V − 1,5 V) / 10 mA = 350 Ω, donc 330 Ω.
On obtient 10,6 mA : au-dessus des 5 mA d'amorçage, le PIC peut le fournir.

À corriger avant d'imprimer
Passer le courant du moteur dans le capteur, ajouter le bornier secteur, revoir R4 en série avec le moteur.

Notes: 1 min. À gauche la commande : RB2 passe par R7 et allume la LED de l'optotriac, qui déclenche la gâchette du triac. Pour R7, le calcul : 5 V moins 1,5 V de LED, divisé par 10 mA, ça donne 350 Ω, on prend 330 Ω. À droite le 6N136 pour le passage par zéro. On s'est inspirés de schémas existants pour le triac parce qu'on n'en avait jamais vu, mais il faut adapter à nos composants. Ce schéma n'est pas encore définitif et je sais ce qu'il reste à corriger.

## La lecture analogique transforme une tension en nombre

Tension
entre 0 et 5 V sur RA0

CAN du PIC
convertisseur analogique numérique

Nombre
que le programme peut comparer

Tension sur RA0 | Sur 8 bits (0 à 255) | Sur 12 bits (0 à 4095)
0 V | 0 | 0
2,5 V (capteur à 0 A) | 128 | 2048
5 V | 255 | 4095
Plus petit écart visible (quantum) | 5 V / 256 = 19,5 mV | 5 V / 4096 = 1,22 mV
Avec le capteur à 20 mV/A | 1 point ≈ 1 A | 1 point ≈ 61 mA

C'est quoi un bit ?
Une case qui vaut 0 ou 1. Plus on a de cases, plus on a de valeurs.
8 bits : 2⁸ = 256 valeurs.
12 bits : 2¹² = 4096 valeurs.
Notre choix
8 bits suffisent pour tester avec le potentiomètre. Il faudra 12 bits avec le vrai capteur.

Notes: 1 min 30. Le PIC ne comprend pas une tension, il comprend des nombres. Le CAN, le convertisseur analogique numérique, découpe la plage de 0 à 5 V en petites marches et donne le numéro de la marche. Sur 8 bits il y a 256 marches, chaque marche fait 19,5 mV. Sur 12 bits il y en a 4096, chaque marche fait 1,22 mV. Pour le test au potentiomètre, 8 bits suffisent. Mais avec le vrai capteur à 20 mV par ampère, sur 8 bits une marche vaut déjà environ 1 A : c'est trop grossier pour une pompe d'environ 1 A. Donc on passera à 12 bits. Le PIC sait le faire : c'est juste le code à adapter.

## Dans le code : lire le CAN et garder un nombre de 8 bits

// main_simple.c
uint8_t courant; // nombre de 0 a 255
uint8_t Lire_Courant(void)
{
return (uint8_t)(ADC_GetConversion(
Capteur_COURANT, negChannel_ADNREF) >> 8);
}

uint8_t
u = sans signe (unsigned), int = entier, 8 = 8 bits. Il va de 0 à 255. On prend le plus petit type qui suffit : le PIC calcule en 8 bits.

ADC_GetConversion
Fonction générée par MCC : elle choisit l'entrée, lance la conversion, attend la fin et renvoie le résultat.

Capteur_COURANT
Le nom donné à RA0 dans MCC, configurée en entrée analogique.

>> 8
Décale de 8 bits vers la droite : on garde seulement les 8 bits les plus importants.

Exemple : le potentiomètre est à 2,5 V
Le CAN mesure sur 12 bits : 2048.
Le résultat est rangé à gauche dans 16 bits, alors >> 8 garde les 8 bits de gauche.
Lire_Courant() renvoie 128, c'est-à-dire le milieu de 0 à 255.

Notes: 1 min. Voilà ma fonction de lecture. uint8_t, ça veut dire entier non signé sur 8 bits, donc un nombre de 0 à 255. ADC_GetConversion est générée par MCC : je choisis l'entrée, elle lance la conversion et me rend le résultat. Le CAN travaille sur 12 bits, le résultat est rangé à gauche, donc en décalant de 8 je garde les 8 bits de poids fort. À 2,5 V, ça donne 128. L'intérêt d'avoir tout mis dans une seule fonction : quand on aura le vrai capteur, il n'y aura que l'intérieur de cette fonction à changer.

## Une machine à cinq états décide de ce que fait le moteur

ARRET

DEMARRAGE

MARCHE

BLOQUE

Moteur coupé. On n'en sort que par le bouton reset.

A_VIDE

case ETAT_MARCHE:
MOTEUR_ON();
if (courant > SEUIL_HAUT) // trop fort
{
compteur_haut = compteur_haut + 1;
compteur_bas = 0;
}
else if (courant < SEUIL_BAS) // trop faible
{ ... }
if (compteur_haut >= DUREE_10S)
{
etat = ETAT_BLOQUE;
}
break;

La boucle
Le while(1) lit le courant et passe dans le switch(etat) toutes les 100 ms.

Les seuils
#define SEUIL_BAS 91 et SEUIL_HAUT 173 : les 3 zones du potentiomètre. À refaire avec le vrai capteur.

Le démarrage
3 s tolérées. Si le courant est encore trop fort à 5 s : BLOQUE.

La confirmation
100 tours de 100 ms = 10 s de défaut avant de couper : un pic isolé ne coupe pas la pompe.

Notes: 1 min 30. Le programme est une machine à états : une variable etat et un switch avec un case par état. Dans MARCHE : si le courant dépasse le seuil haut, j'augmente un compteur ; s'il redevient normal, je remets à zéro. Au bout de 100 tours de 100 ms, soit 10 secondes, je passe en BLOQUE et je coupe le moteur. Comme ça, un pic isolé ne coupe pas la pompe. Pour le moment, le potentiomètre remplace le courant : c'est pour ça que les seuils sont 91 et 173. Le __delay_ms(100) bloque le programme pendant l'attente : pour la suite, on veut passer par des interruptions pour que le PIC puisse faire autre chose en même temps.

## Ce qu'on a, ce qu'il reste à faire, ce qu'on va obtenir

Bloc | Ce qu'on a | Reste à faire | Ce qu'on va obtenir
Mesure | Lecture analogique testée au potentiomètre, valeurs relevées sous RealTerm | Brancher l'ACS756, passer à 12 bits, mesurer sur la période | Le vrai courant du moteur
Commande | BTA12 et MOC3023 choisis, schéma KiCad | Fixer les résistances, tester sur la pompe | Le PIC coupe le moteur en 230 V
Détection du zéro | 6N136 ajouté au schéma | Fixer ses valeurs, le relier au programme | Des mesures au bon moment
Programme | Deux seuils testés sur LED ; machine à 5 états écrite et compilée | Vrais seuils, interruptions, lancement tous les 3 jours | Bloqué, à vide ou en marche reconnu seul
Carte | Carte SAE22 pour les essais, typons en cours | Finir le schéma, imprimer, souder | La carte finale du projet
Évolutions | Pilote LCD et affichage de l'état écrits | LCD sur la carte, boutons, ESP32 | Alerte par mail, sans descendre à la cave

Prochaine étape : imprimer la carte, puis tester bloc par bloc : capteur et triac d'abord, puis optocoupleur, puis LED et LCD.

Notes: 1 min. Je distingue bien ce qui est fait de ce qui reste. Ce qui marche aujourd'hui : la lecture analogique et les seuils, testés au potentiomètre sur l'ancienne carte. On n'a pas encore de résultat avec le vrai capteur et le 230 V, parce que la carte n'est pas imprimée. On a un peu de retard sur le code. Pour rattraper : on avance bloc par bloc, et le code est prêt à recevoir le vrai capteur, il n'y aura que la fonction de lecture à changer. La date de fin ne change pas. [Montrer le planning si besoin.]

## Conclusion

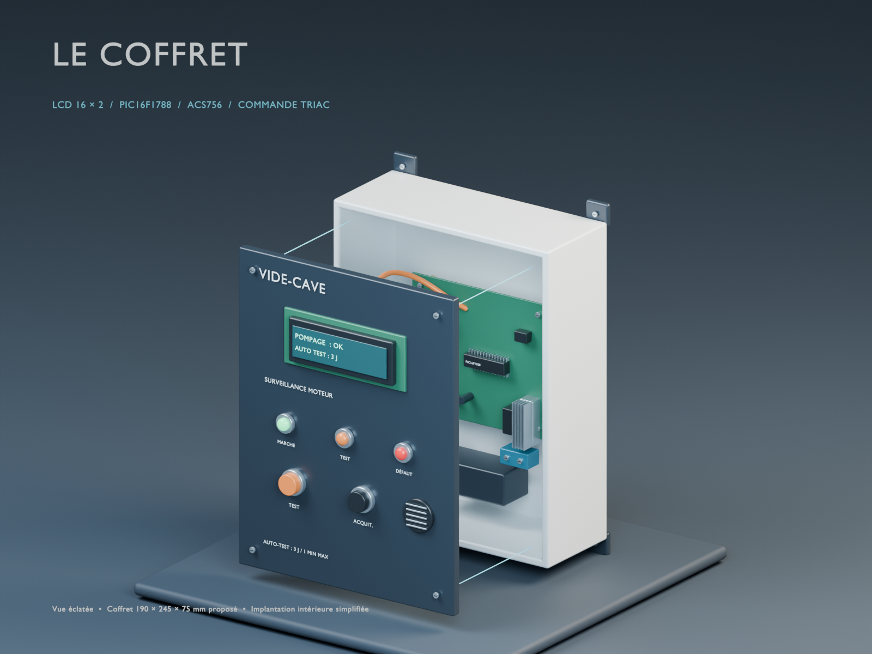
[picture p17: figure]
Vue éclatée du coffret de commande

Le principe et le code sont là : il reste à passer du potentiomètre au vrai capteur, sur la carte finale

Lecture analogique et CAN, configuration MCC sous MPLAB, machine à états, triac et optotriac, KiCad, Git à deux

Acquis

Difficultés

On a cherché des composants sur internet alors qu'ils étaient à l'IUT : il fallait demander tôt. Connexion du SNAP, reprise d'une carte existante

Part de chacun

Moi : choix des composants, broches du PIC, code et lecture analogique. Mon binôme : KiCad, schéma, typons

Notes: 45 s. Pour conclure : on a le principe, les composants et une bonne base de code. Il nous reste à imprimer la carte, tester avec le vrai capteur et adapter le code. Ce que je retiens : la lecture analogique, qu'on n'avait pas encore vue en cours, et le fait qu'il faut demander les composants disponibles dès le début. Merci, je suis prêt pour vos questions.
