glm02/projet-vide-cave/01_Documents/Soutenance_et_conception/Mesures_RealTerm_simple.xlsx

Lecture du potentiomètre sur RA0 (ancienne carte, RealTerm)
Mesure | Valeur lue sur RealTerm | Valeur sur 8 bits | Tension (V)
1 | 65520
2 | 65520
3 | 56368
4 | 44592
5 | 23792
6 | 3312
7 | 2544
8 | 2560
Valeur sur 8 bits = valeur lue / 256
Tension = valeur sur 8 bits × 5 / 256
Le potentiomètre va de 9 à 255. Trois zones égales : (255 - 9) / 3 = 82, donc les seuils 91 et 173.
