glm02/projet-vide-cave/optotriac image.md

---
title: "optotriac image"
source: "https://search.brave.com/images?q=optotriac+image&source=images"
author:
published:
created: 2026-10-12
description: "Recherchez sur le Web. Anonymement. Des résultats vraiment utiles, améliorés par IA. Le tout, grâce à un index indépendant, sans ciblage ni parti pris."
tags:
  - "clippings"
---
 2 pièces Circuit intégré Moc 3021 – moc3021 optotriac 400 V 15 mA Optotriac phototriac 15mA 400 V DIP-6 Optotriac Nom : electronique_interface_230V_001.gif Affichages : 5752 Taille : 14,0 Ko Optotriac 7,5 kV 400 V 15 mA CMS6 main product photo Circuito optotriac Optotriac typical application circuit from Fairchild (now On Semi) Nom : light-dimmer-schematic1.gif Affichages : 3760 Taille : 59,3 Ko  Optotriac 7,5 kV 400 V 15 mA CMS6 MOC3021 OptoAcoplador de Fase Aleatoria - OptoTriac DIP6 Opto Triac con Salida FotoTriac tipo Aislador, Ferretrónica Nom : dimmerinstructables.jpg Affichages : 4066 Taille : 35,1 Ko Optotriac MOC3020  Optotriac circuit example Image principale du produit Optotriac MOC3020 OPTOTRIAC example on a circuit schematic piloter un triac avec arduino ou pic 2

Trouver ailleurs

- [
	Bing
	](https://search.brave.com/images?q=optotriac+image+%21bi&source=images)
- [
	Google
	](https://search.brave.com/images?q=optotriac+image+%21gi&source=images)

Triac  interface_230V_001_proto_001c interface_230V_001_pcb_3d_a rc_integre_001a   interface_230V_001b_pcb_3d_a piloter un triac avec arduino ou pic 6 electronique_triac_001c2 PIR How to Use Verified Symbols, Footprints, and 3D Models for New Components in OrCAD X CIP piloter un triac avec arduino ou pic 3 interface_230V_001_proto_001a   proto-22 electronique_triac_001f  EMI Reduction Techniques for Switching Power Supply PCB Layouts Picture 1 of 1 Crossing Circuit 10 x PS2561-1 NEC OPTOISOLATOR 5KV TRANSISTOR PHOTOCOUPLER 4PIN DIP UKINSTOCK proto-18   moc3041
