glm02/projet-vide-cave/01_Documents/Presentation/projet_vide_cave_geii.pptx

PROJET IUT GEII 2ᵉ ANNÉE

Surveillance d'un vide-cave

Moteur asynchrone monophasé 230 V — protection par mesure de courant

Objectif : vérifier automatiquement le bon fonctionnement de la pompe. Un démarrage automatique est déclenché tous les 3 jours, pendant 1 minute maximum, avec mesure du courant moteur dès le démarrage. Le moteur est également surveillé pendant son utilisation normale.

PRINCIPE DE DÉTECTION

Courant élevé → protection / arrêt — moteur bloqué ou grippé

Courant faible → pompe à vide / arrêt — absence d'eau

Courant normal → fonctionnement autorisé

## Slide 2

SOLUTION TECHNIQUE

Chaîne de mesure et de protection du moteur

1

2

3

4

Moteur
230 V

Pompe du
vide-cave

Mesure du
courant

Acquisition en
temps réel

Microcontroleur
& logique

Analyse du niveau
de courant mesuré

Commande
/ arrêt

Autorise ou coupe
le fonctionnement

Principe : Un micrcontroleur compare en continu le courant mesuré à des seuils de référence. Un courant trop élevé signale un moteur bloqué et déclenche l'arrêt de protection ; un courant trop faible signale un fonctionnement à vide ; un courant normal autorise la poursuite du fonctionnement.

Projet IUT GEII 2ᵉ année

## Slide 3

SUPERVISION & COMMUNICATION

Supervision, affichage et communication

Un projet mêlant mesure, automatisme, programmation, IHM et réseaux.

LCD — informations utilisateur

- État : ARRÊT / DÉMARRAGE / FONCTIONNEMENT
- Courant instantané
- Temps de fonctionnement
- Nombre de démarrages
- Résultat du dernier test
- Défaut : surintensité ou courant insuffisant

Évolution — Wi-Fi

- ESP32 connecté à un serveur
- Historique des démarrages et des défauts
- Courbes de courant et de temps de fonctionnement
- Consultation des données à distance

Compétences GEII mobilisées

Électronique • Mesure • Automatisme • Programmation • IHM • Réseaux/Wi-Fi • Traitement des données
