glm02/projet-vide-cave/03_Electronique/Documentation/pickit_connexion.pdf

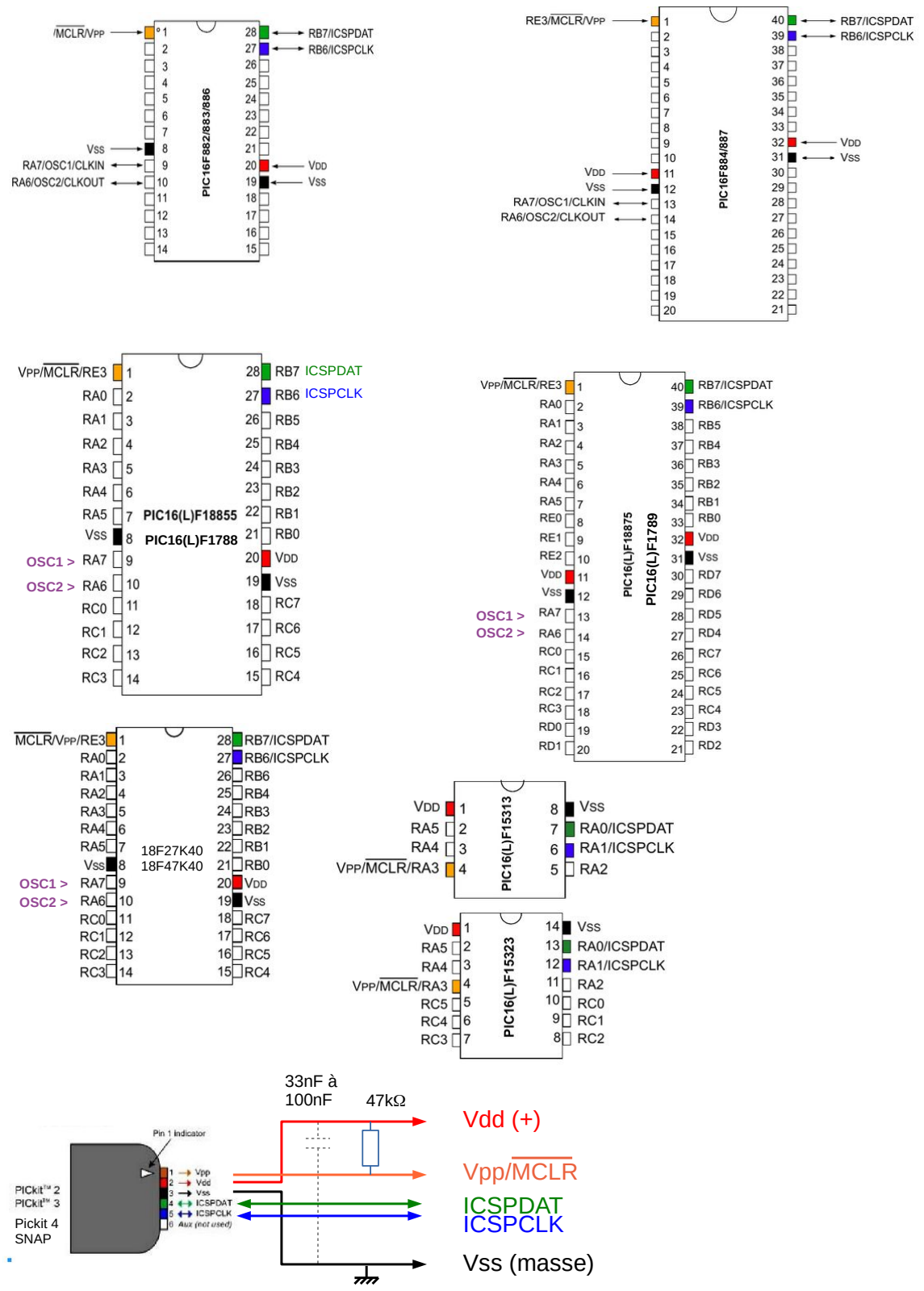
[picture p18: page 1]

Pickit 4
SNAP

47kW

33nF à
100nF
Vdd (+)

Vpp/MCLR
ICSPDAT
ICSPCLK
Vss (masse)

18F27K40
18F47K40
OSC1 >
OSC2 >

OSC1 >
OSC2 >

ICSPDAT
ICSPCLK

PIC16(L)F1788

OSC1 >
OSC2 >

PIC16(L)F1789

# dsPIC

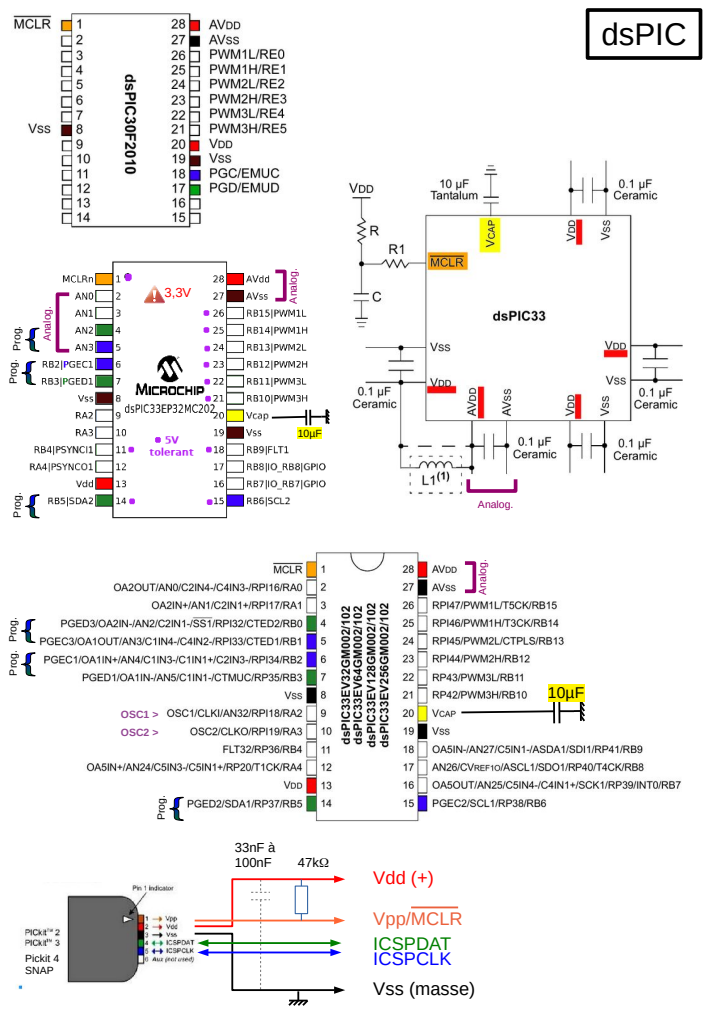
[picture p19: page 2]
Pickit 4 SNAP; Vdd (+); Vpp/MCLR ICSPDAT ICSPCLK; Prog. Prog.; Prog.; Analog.; OSC1 >; OSC2 >

# USB

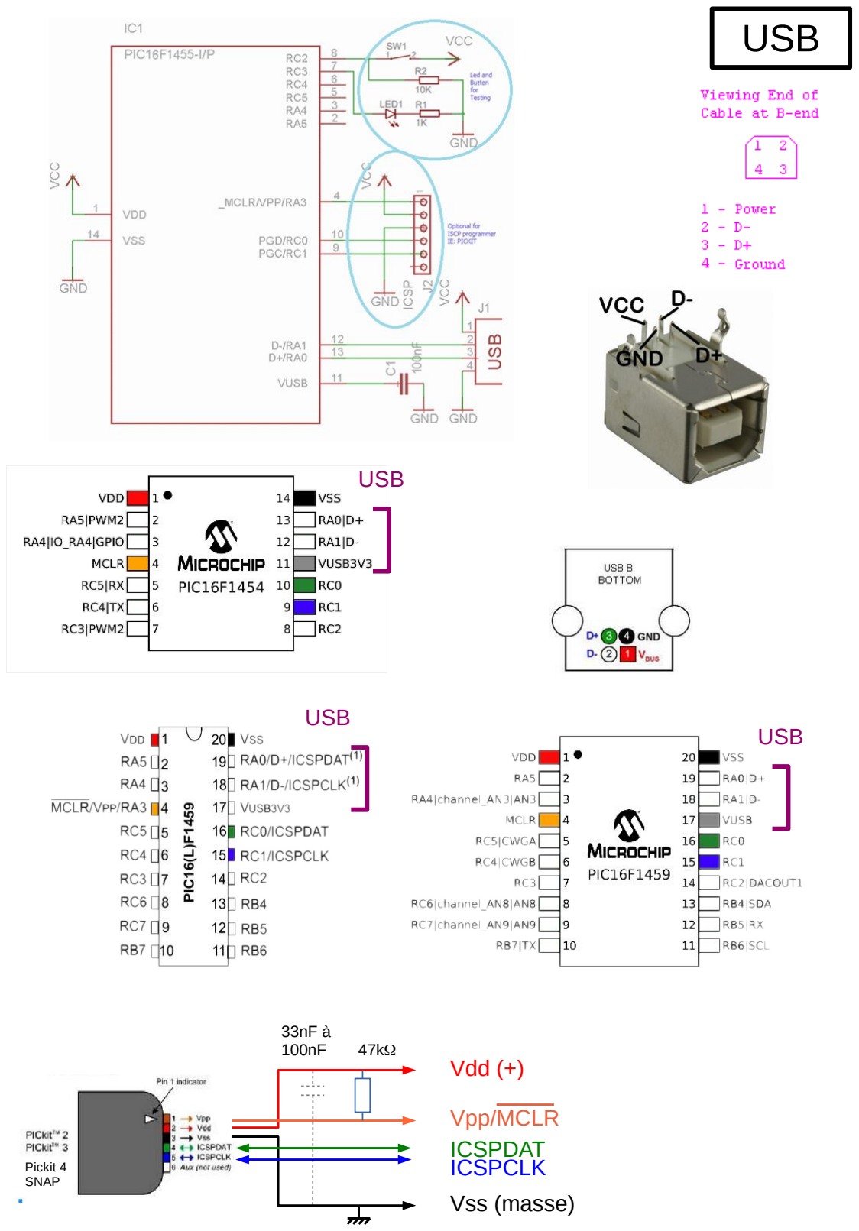
[picture p20: page 3]

Pickit 4
SNAP

47kW

33nF à
100nF
Vdd (+)

Vpp/MCLR
ICSPDAT
ICSPCLK

USB
USB

USB

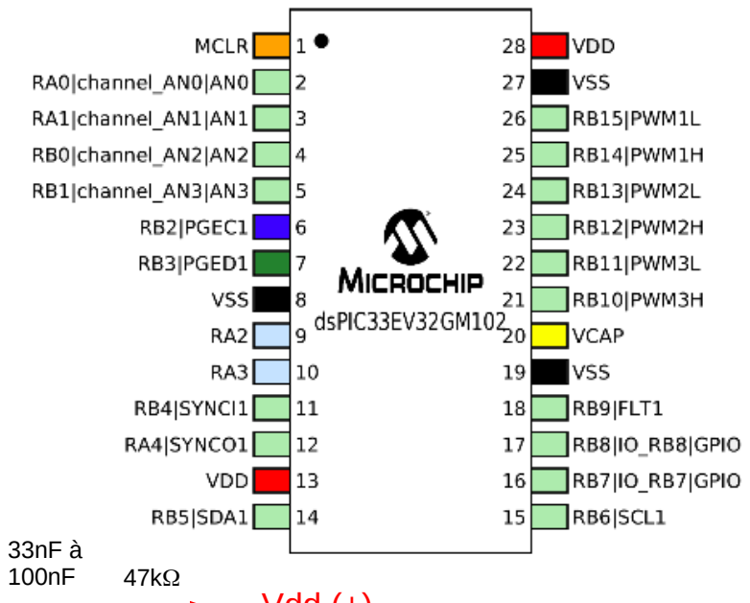
[picture p21: figure]
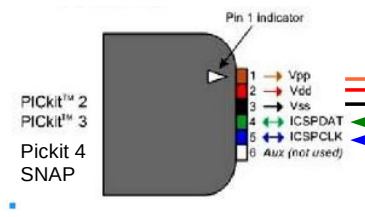
[picture p22: figure]
Pickit 4 SNAP

Vdd (+)

Vpp/MCLR
ICSPDAT
ICSPCLK
