glm02/projet-vide-cave/02_Synoptiques/Synoptique projet version 2.drawio.png

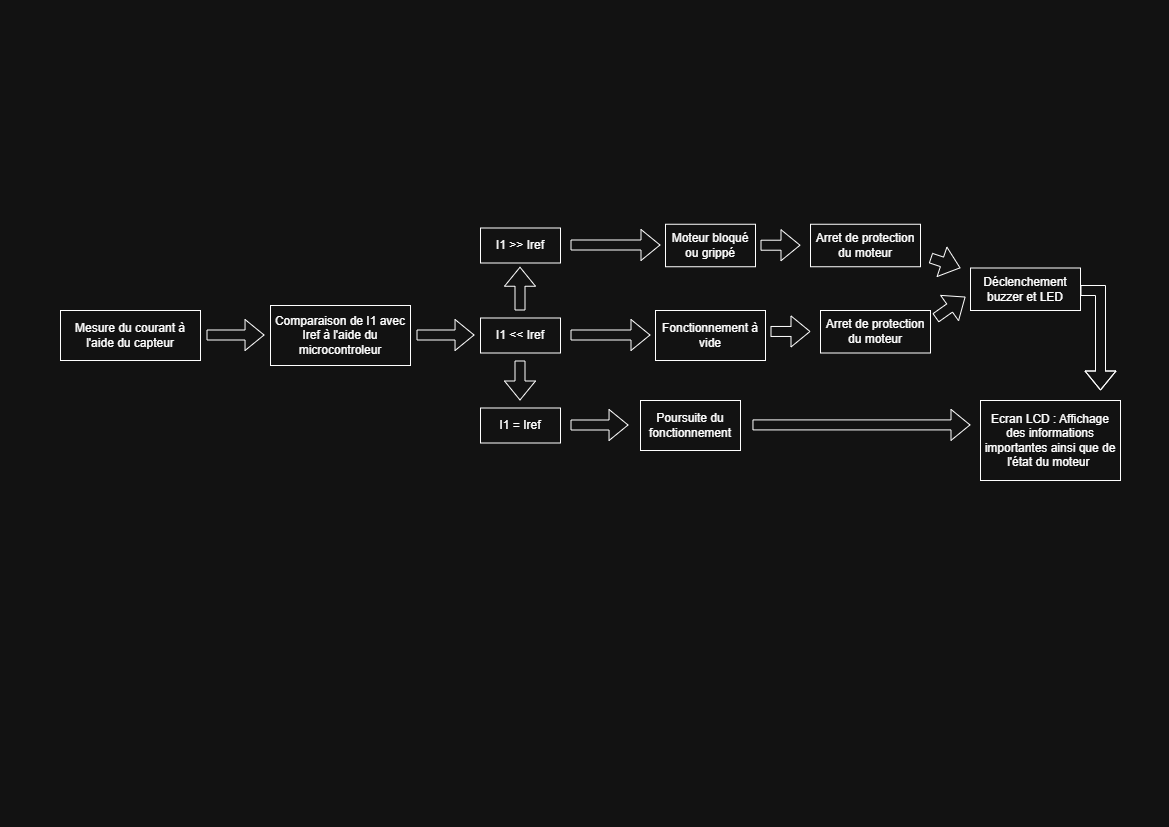
02_Synoptiques/Synoptique projet version 2.drawio.png
