glm02/projet-vide-cave/02_Synoptiques/Synoptique projet.drawio.png

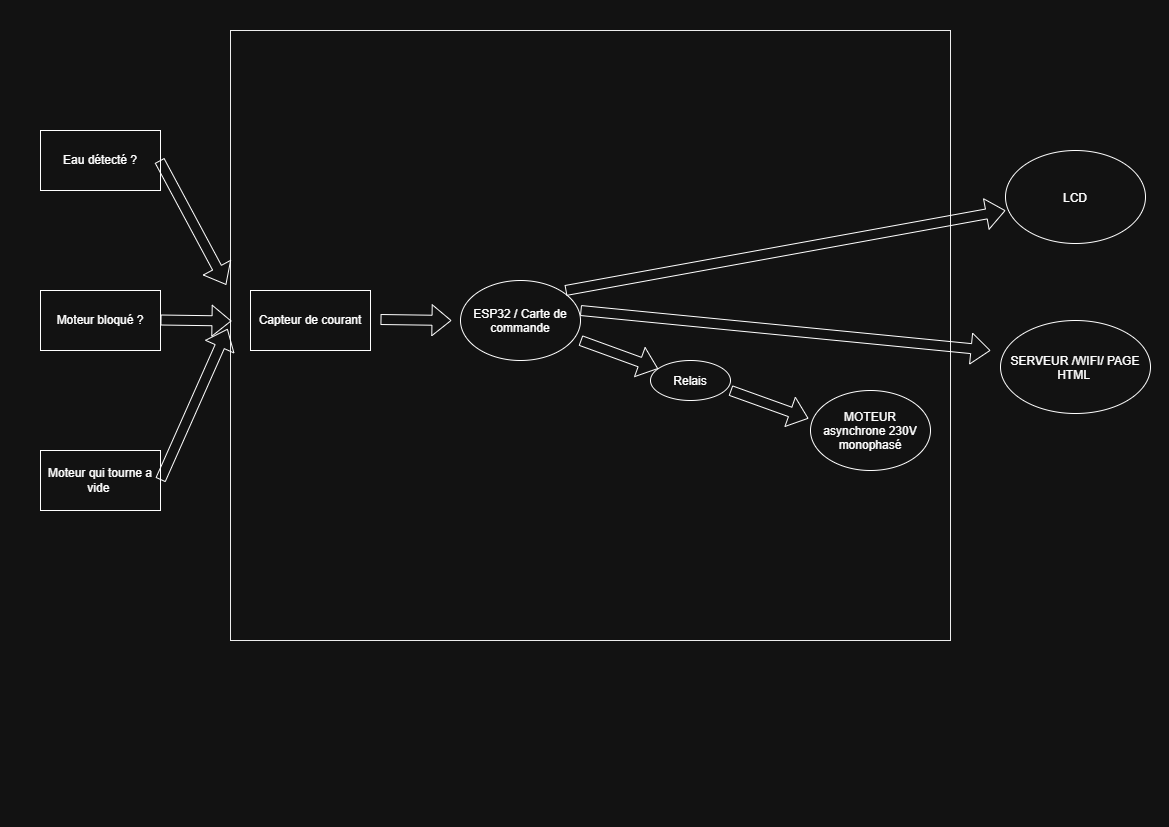
02_Synoptiques/Synoptique projet.drawio.png
