glm02/projet-vide-cave/03_Electronique/Carte_vide_cave_PIC_Allegro_TRIAC/exports/Schema.png

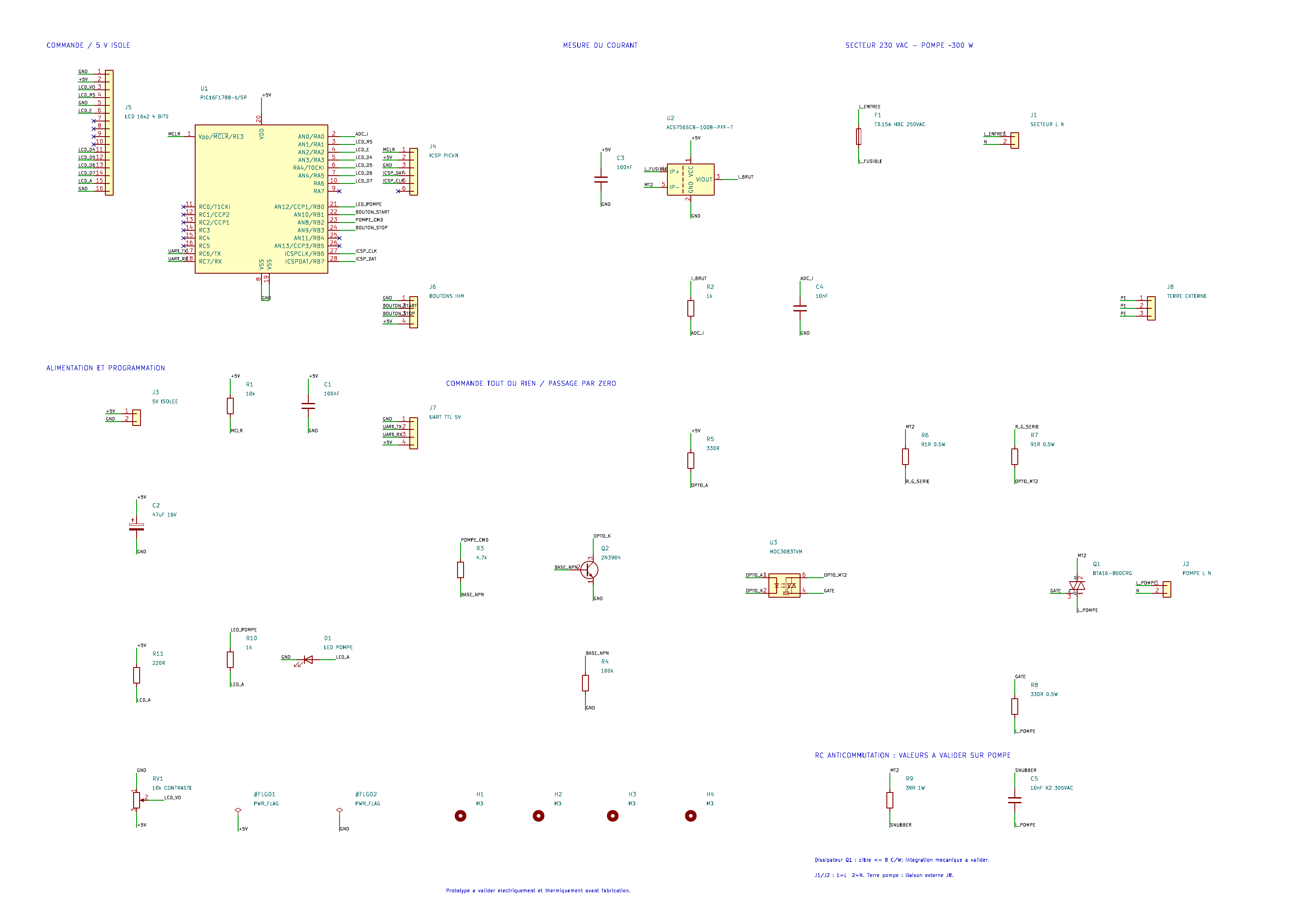
03_Electronique/Carte_vide_cave_PIC_Allegro_TRIAC/exports/Schema.png
