glm02/projet-vide-cave/03_Electronique/Carte_vide_cave_PIC_Allegro_TRIAC/exports/typons/B_Cu_contact.png

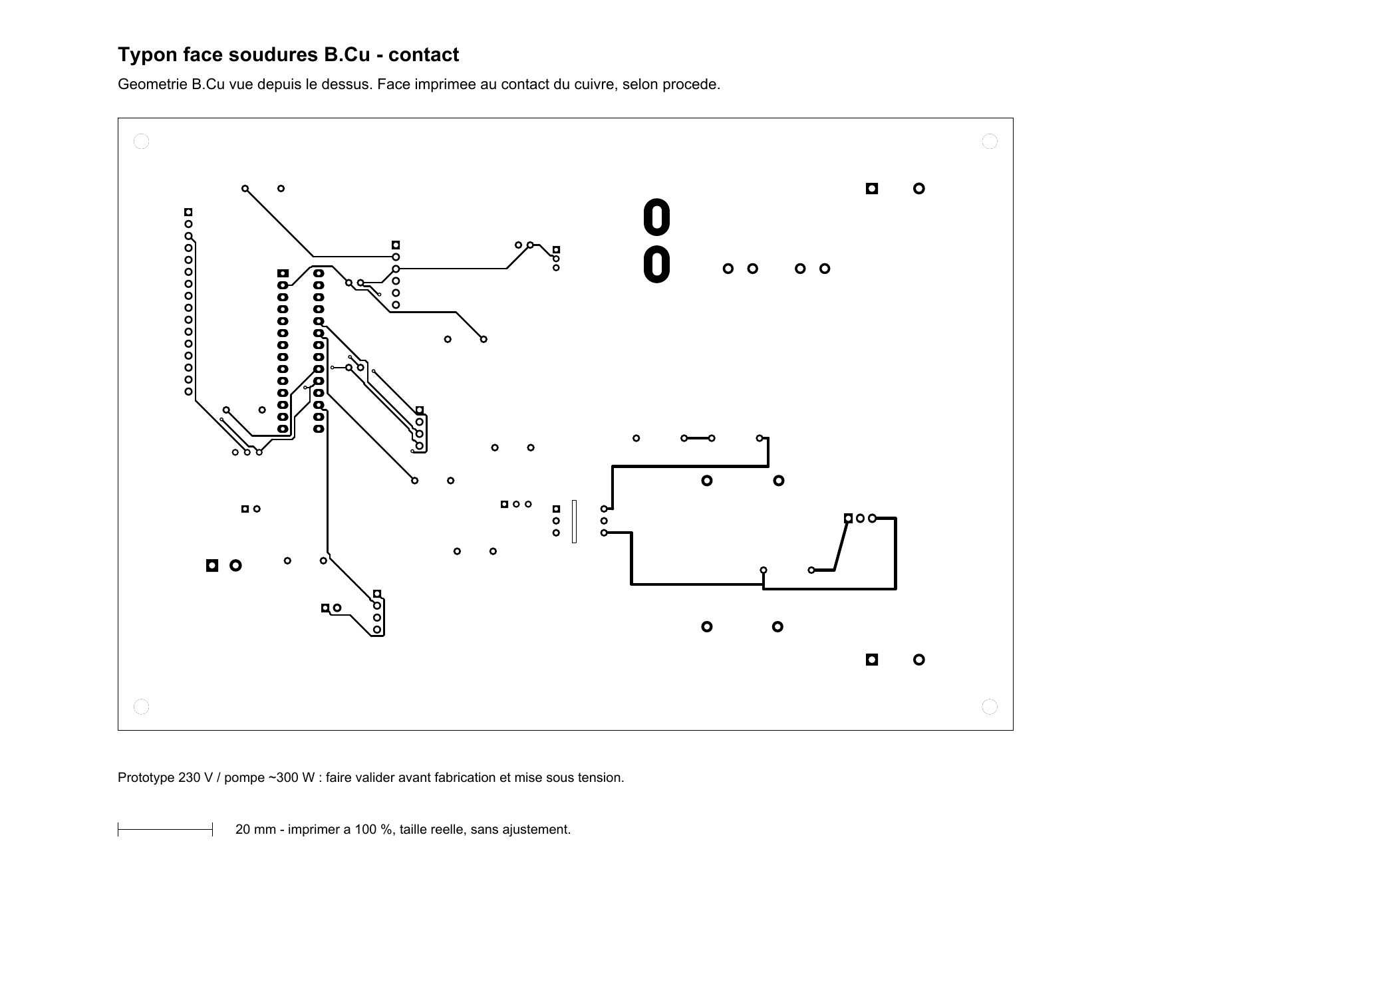
03_Electronique/Carte_vide_cave_PIC_Allegro_TRIAC/exports/typons/B_Cu_contact.png
