glm02/projet-vide-cave/03_Electronique/Carte_vide_cave_PIC_Allegro_TRIAC/exports/typons/F_Cu_contact_miroir.png

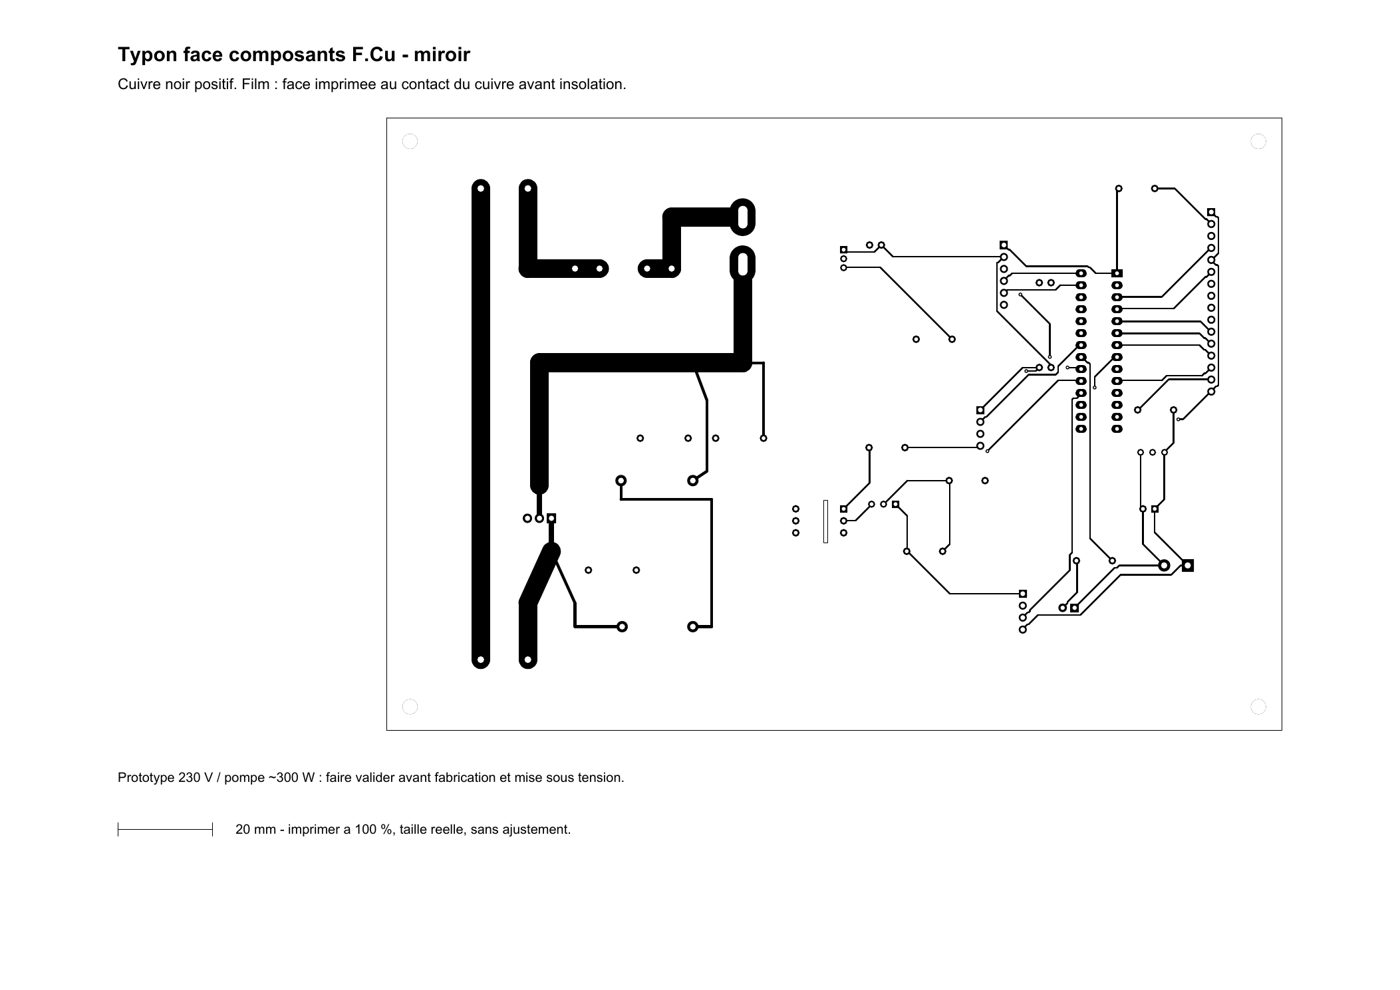
03_Electronique/Carte_vide_cave_PIC_Allegro_TRIAC/exports/typons/F_Cu_contact_miroir.png
