glm02/projet-vide-cave/03_Electronique/Carte_vide_cave_PIC_Allegro_TRIAC/sources/ACS756_10.png

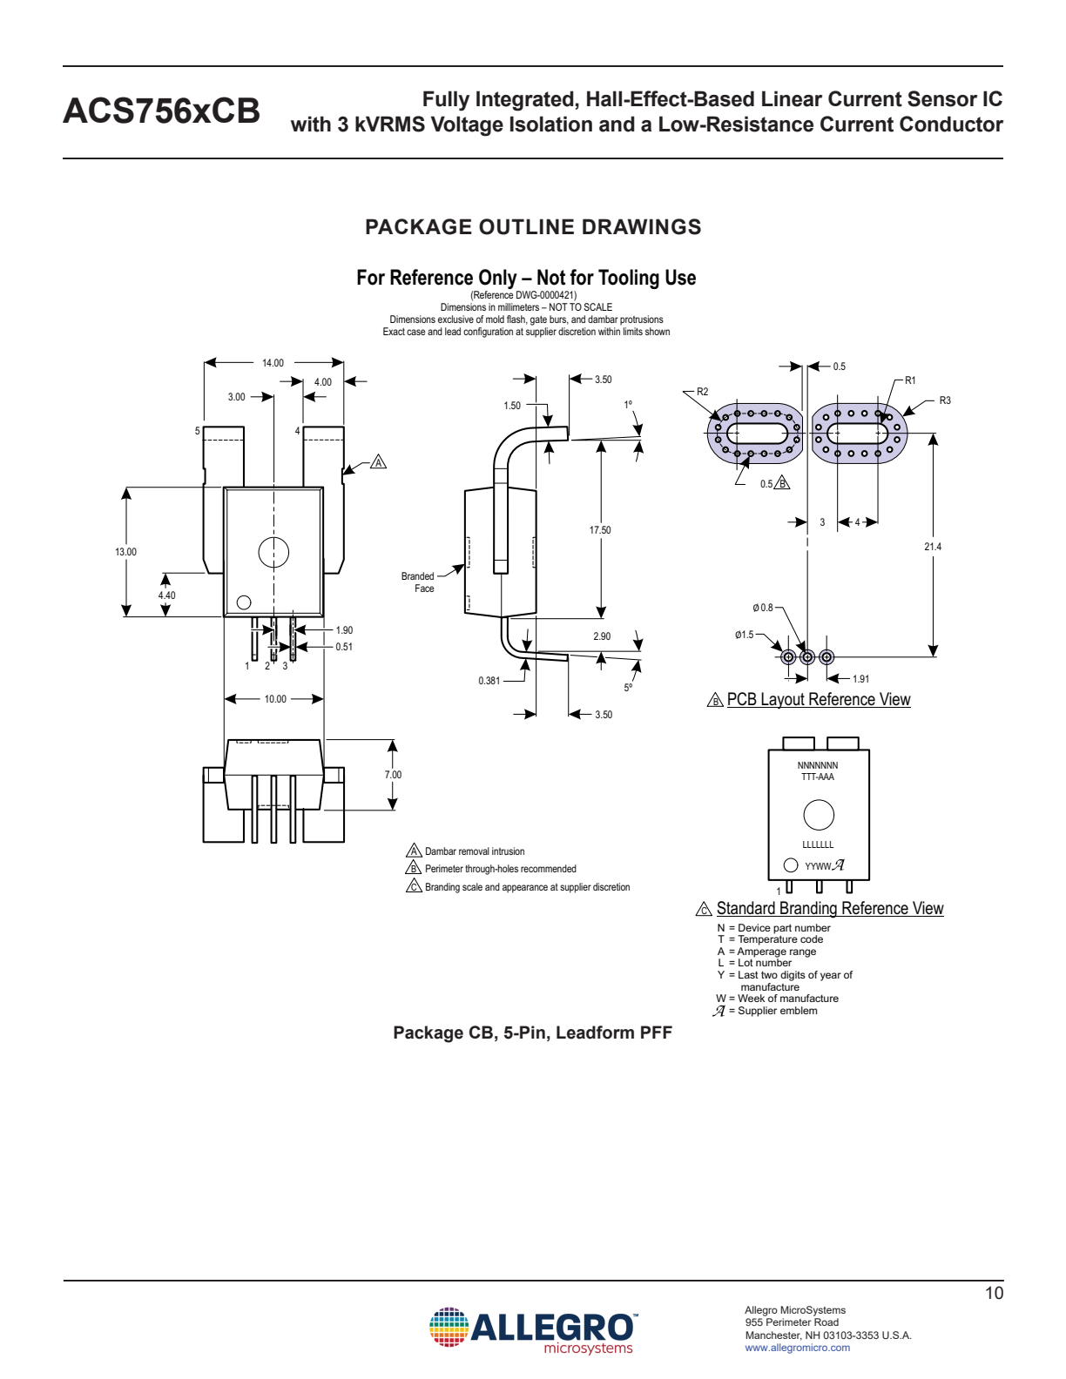
03_Electronique/Carte_vide_cave_PIC_Allegro_TRIAC/sources/ACS756_10.png
