glm02/projet-vide-cave/03_Electronique/Carte_vide_cave_PIC_Allegro_TRIAC/sources/ACS756_11.png

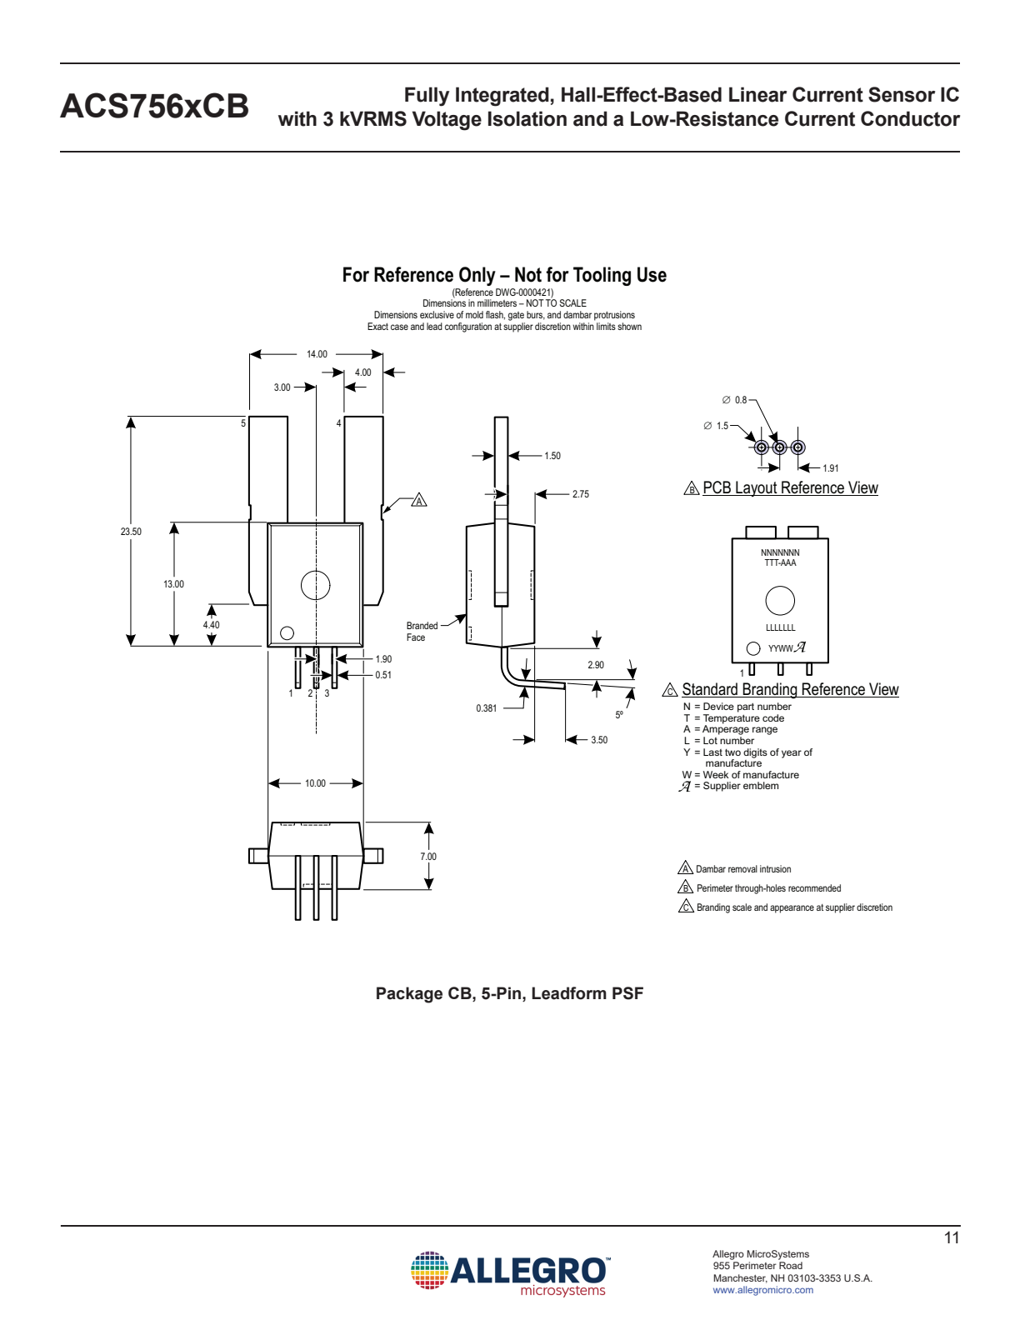
03_Electronique/Carte_vide_cave_PIC_Allegro_TRIAC/sources/ACS756_11.png
