glm02/projet-vide-cave/05_Notes/Obsidian/Images/Schema 6N136.png

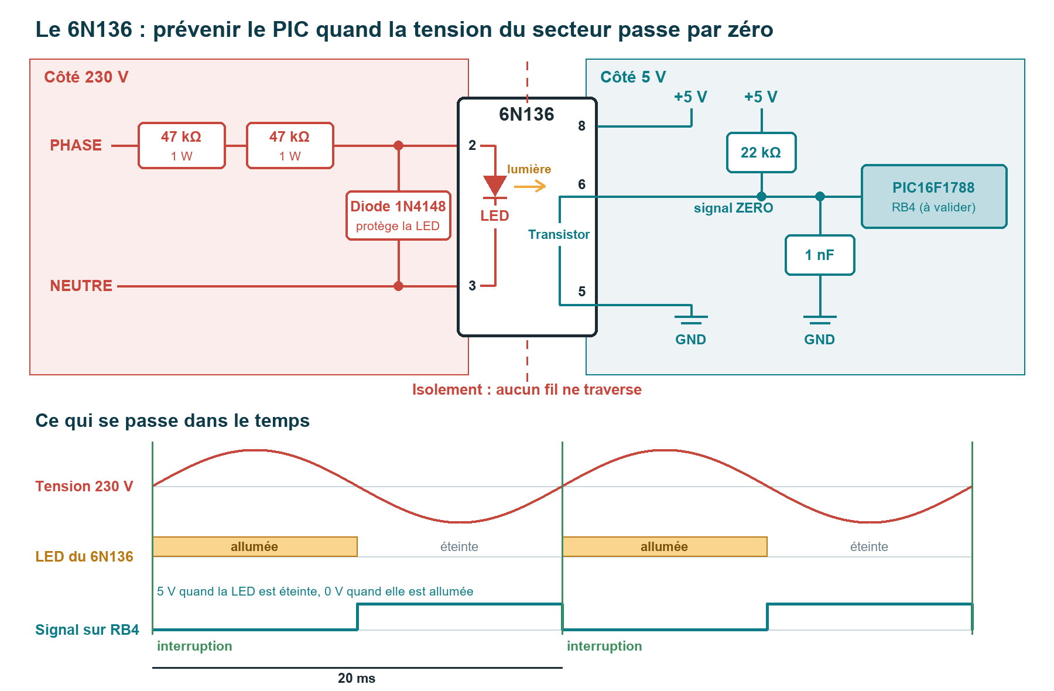
05_Notes/Obsidian/Images/Schema 6N136.png
