glm02/projet-vide-cave/07_Visualisation_Anatomy/pcb-nettoye.png

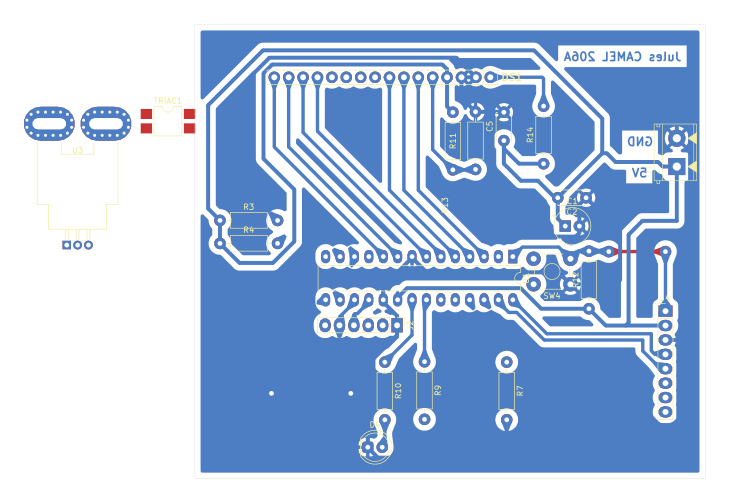
07_Visualisation_Anatomy/pcb-nettoye.png
