glm02/projet-vide-cave/03_Electronique/G206A_CAMEL_TP_CAO/Nomenclature_G206_groupee.csv

Reference | Qty | Value | Footprint | MPN | Manufacturer | Chosen_Distributor | Datasheet | Validated | DNP | Notes
BZ1 | 1 | Buzzer
C1 | 1 | 47uF | CP_Radial_D6.3mm_P2.50mm
C2,C5 | 2 | 100n | Disc_D4.7mm_W2.5mm_P5.00mm
D4 | 1 | LED R | LED_D5.0mm
DS1 | 1 | 162B-CC_BC-3LP | 162B |  |  |  | http://www.icbank.com/data/ICBShop/board/HY1602E.pdf
J1 | 1 | Alimentation | Bornier_1x02_L10mm_W7.5mm_P5mm
J2 | 1 | Série (TTL) | PinHeader_1x06_P2.54mm_Vertical
J4 | 1 | Conn_PIC_ICSP_ICD | PicKit_4_Snap_1x08_P2.54mm_Vertical |  |  |  | http://ww1.microchip.com/downloads/en/devicedoc/30277d.pdf
M1 | 1 | Motor_AC
R3,R7,R4 | 3 | R
R9,R14,R10 | 3 | 270 | Axial_DIN0207_L6.3mm_D2.5mm_P10.16mm_Horizontal
R11 | 1 | 56k | Axial_DIN0207_L6.3mm_D2.5mm_P10.16mm_Horizontal
R12 | 1 | 10k | Axial_DIN0207_L6.3mm_D2.5mm_P10.16mm_Horizontal
R13 | 1 | 1,5k | Axial_DIN0207_L6.3mm_D2.5mm_P10.16mm_Horizontal
SW4 | 1 | B3F-1000 | SW_TH_Tactile_Omron_B3F-10xx
TRIAC1 | 1 | octo-triac | SMDIP-4_W7.62mm |  |  |  | https://www.onsemi.com/pub/Collateral/FODM3053_NF098-D.PDF
Triac_de_puissance1 | 1 | Generic_Triac_A1A2G
U1 | 1 | PIC16F1788-xSP | DIP-28_W7.62mm_LongPads |  |  |  | http://ww1.microchip.com/downloads/en/DeviceDoc/40001675C.pdf
U3 | 1 | Capteur de courant | Allegro_CB_PFF |  |  |  | http://www.allegromicro.com/~/media/Files/Datasheets/ACS756-Datasheet.ashx?la=en
