glm02/projet-vide-cave/(list of files, cad)

Other CAD files:
04_Maquette_3D/Vide_cave_GEII.blend
