glm02/projet-vide-cave/05_Notes/Etude_MOC3041/capteur_gain_resultats.txt

LTspice 26.0.1 for Windows
Circuit: C:\Users\rafae\Documents\Ecole\Projet vide cave\05_Notes\Etude_MOC3041\capteur_gain.cir
Start Time: Mon Oct 12 15:12:55 2026
Options:plotwinsize=0

.step irms=2 gain=1
solver = Normal
Maximum thread count: 18
tnom = 27
temp = 27
method = trap
Compress1stOrder = true
Compress2ndOrder = true
Direct Newton iteration succeeded in finding operating point.

.step irms=10 gain=1
Direct Newton iteration succeeded in finding operating point.

.step irms=15 gain=1
Direct Newton iteration succeeded in finding operating point.

.step irms=2 gain=5
Direct Newton iteration succeeded in finding operating point.

.step irms=10 gain=5
Direct Newton iteration succeeded in finding operating point.

.step irms=15 gain=5
Direct Newton iteration succeeded in finding operating point.

.step irms=2 gain=10
Direct Newton iteration succeeded in finding operating point.

.step irms=10 gain=10
Direct Newton iteration succeeded in finding operating point.

.step irms=15 gain=10
Direct Newton iteration succeeded in finding operating point.
Total elapsed time: 0.709 seconds.

Files loaded:
C:\Users\rafae\Documents\Ecole\Projet vide cave\05_Notes\Etude_MOC3041\capteur_gain.cir

Measurement: vout_min
  step	MIN(V(out) )	FROM	TO
     1	2.44343137741	0.06	0.1
     2	2.21715736389	0.06	0.1
     3	2.07573604584	0.06	0.1
     4	2.21715736389	0.06	0.1
     5	1.08578646183	0.06	0.1
     6	0.37867975235	0.06	0.1
     7	1.93431484699	0.06	0.1
     8	0.20000000298	0.06	0.1
     9	0.20000000298	0.06	0.1

Measurement: vout_max
  step	MAX(V(out) )	FROM	TO
     1	2.55656862259	0.06	0.1
     2	2.78284263611	0.06	0.1
     3	2.92426395416	0.06	0.1
     4	2.78284263611	0.06	0.1
     5	3.91421198845	0.06	0.1
     6	4.62131977081	0.06	0.1
     7	3.06568527222	0.06	0.1
     8	4.80386781693	0.06	0.1
     9	4.80000019073	0.06	0.1

Measurement: vac_rms
  step	RMS((V(out)-2.5) )	FROM	TO
     1	0.0399999706426	0.06	0.1
     2	0.199999837132	0.06	0.1
     3	0.299999751743	0.06	0.1
     4	0.199999837132	0.06	0.1
     5	0.999999177642	0.06	0.1
     6	1.50012802274	0.06	0.1
     7	0.399999668975	0.06	0.1
     8	1.81795471326	0.06	0.1
     9	2.00827301042	0.06	0.1
