glm02/projet-vide-cave/05_Notes/Etude_MOC3041/led_moc3041_resultats.txt

LTspice 26.0.1 for Windows
Circuit: C:\Users\rafae\Documents\Ecole\Projet vide cave\05_Notes\Etude_MOC3041\led_moc3041.cir
Start Time: Mon Oct 12 15:12:53 2026

.step rled=150 corner=-1
solver = Normal
Maximum thread count: 18
tnom = 27
temp = 27
method = trap
Compress1stOrder = true
Compress2ndOrder = true
Direct Newton iteration succeeded in finding operating point.

.step rled=180 corner=-1
Direct Newton iteration succeeded in finding operating point.

.step rled=220 corner=-1
Direct Newton iteration succeeded in finding operating point.

.step rled=270 corner=-1
Direct Newton iteration succeeded in finding operating point.

.step rled=150 corner=0
Direct Newton iteration succeeded in finding operating point.

.step rled=180 corner=0
Direct Newton iteration succeeded in finding operating point.

.step rled=220 corner=0
Direct Newton iteration succeeded in finding operating point.

.step rled=270 corner=0
Direct Newton iteration succeeded in finding operating point.

.step rled=150 corner=1
Direct Newton iteration succeeded in finding operating point.

.step rled=180 corner=1
Direct Newton iteration succeeded in finding operating point.

.step rled=220 corner=1
Direct Newton iteration succeeded in finding operating point.

.step rled=270 corner=1
Direct Newton iteration succeeded in finding operating point.
Total elapsed time: 0.266 seconds.

Files loaded:
C:\Users\rafae\Documents\Ecole\Projet vide cave\05_Notes\Etude_MOC3041\led_moc3041.cir

Measurement: i_led
  step	AVG(I(Rled))	FROM	TO
     1	0.0193650797009	0	0.001
     2	0.0161375664175	0	0.001
     3	0.0132034635171	0	0.001
     4	0.0107583776116	0	0.001
     5	0.0236666668206	0	0.001
     6	0.0197222214192	0	0.001
     7	0.0161363631487	0	0.001
     8	0.0131481485441	0	0.001
     9	0.0284210518003	0	0.001
    10	0.0236842110753	0	0.001
    11	0.0193779896945	0	0.001
    12	0.0157894734293	0	0.001

Measurement: p_res
  step	AVG(V(rail,anode)*I(Rled))	FROM	TO
     1	0.0590634921645	0	0.001
     2	0.0492195768037	0	0.001
     3	0.0402705630977	0	0.001
     4	0.0328130512025	0	0.001
     5	0.0840166660848	0	0.001
     6	0.0700138850978	0	0.001
     7	0.0572840884084	0	0.001
     8	0.0466759267047	0	0.001
     9	0.115105258436	0	0.001
    10	0.0959210537256	0	0.001
    11	0.0784808573386	0	0.001
    12	0.0639473666359	0	0.001
