glm02/projet-vide-cave/05_Notes/Obsidian/08 - Journal de travail.md

---
tags: [vide-cave, journal]
date: 2026-10-12
---
# Journal de travail

Retour : [[00 - Accueil]] · Tâches : [[05 - Taches]]

## 2026-10-12 — Analyse et organisation

Carte de référence : G206_CAMEL_TP_CAO. Analyse du schéma, de l'ancienne implantation et du rapport de pré-étude ; nettoyage des éléments hérités uniquement sur le PCB. Les composants du schéma et les paramètres de conception sont conservés. Les règles bleu B.Cu / peu de straps rouges F.Cu sont consignées.

Création du coffre Obsidian et des métadonnées du dépôt pour travailler depuis plusieurs ordinateurs. Les notes personnelles antérieures restent en place. Le [rapport technique](../Analyse_G206_2026-10-12/RAPPORT_ANALYSE.md) porte les résultats détaillés et les contrôles finaux.

## Modèle pour les prochaines séances

Copier ce bloc à chaque séance et remplacer les éléments entre crochets.

```markdown
## AAAA-MM-JJ — [Objectif]

Personne / poste : [nom ou machine]
Fichiers travaillés : [chemins relatifs]
Point de départ : [commit ou état]

Modifications réalisées :
- [modification et raison]

Vérifications :
- [ERC/DRC, inspection ou essai et résultat]

Décisions :
- [décision et preuve / donnée utilisée]

À reprendre :
- [tâche précise]

Commit partagé : [identifiant]
```
