glm02/projet-vide-cave/02_Synoptiques/Synoptique projet.drawio.pdf

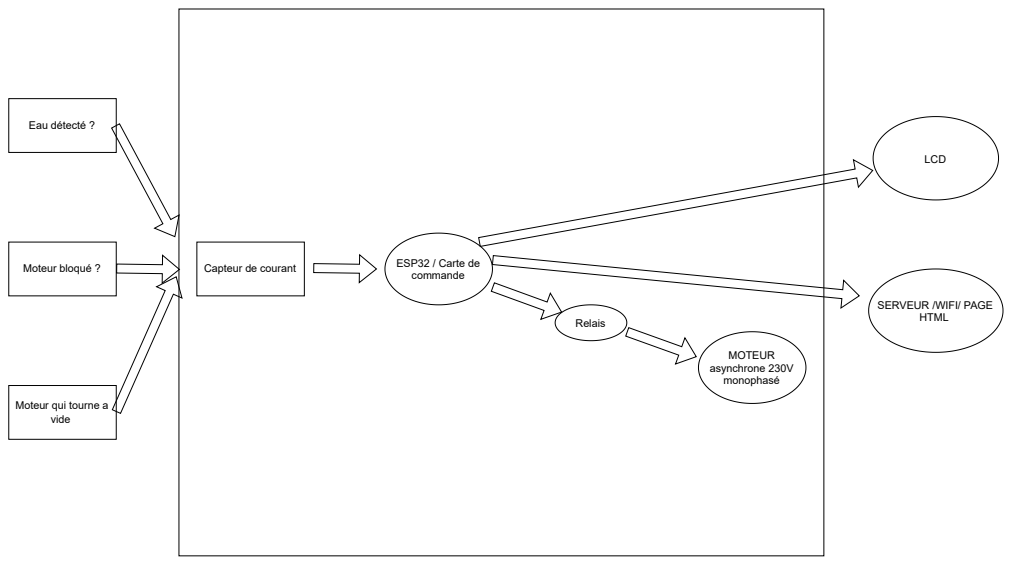
[picture p33: page 1]
LCD; ESP32 / Carte de commande; MOTEUR asynchrone 230V monophasé; HTML; Moteur bloqué ?; Eau détecté ?; Relais

Capteur de courant

SERVEUR /WIFI/ PAGE

Moteur qui tourne a
vide
