glm02/projet-vide-cave/03_Electronique/Carte_vide_cave_PIC_Allegro_TRIAC/exports/Implantation.pdf

J5 | R10 | C1 RV1

## Implantation - vide-cave 230 V / environ 300 W

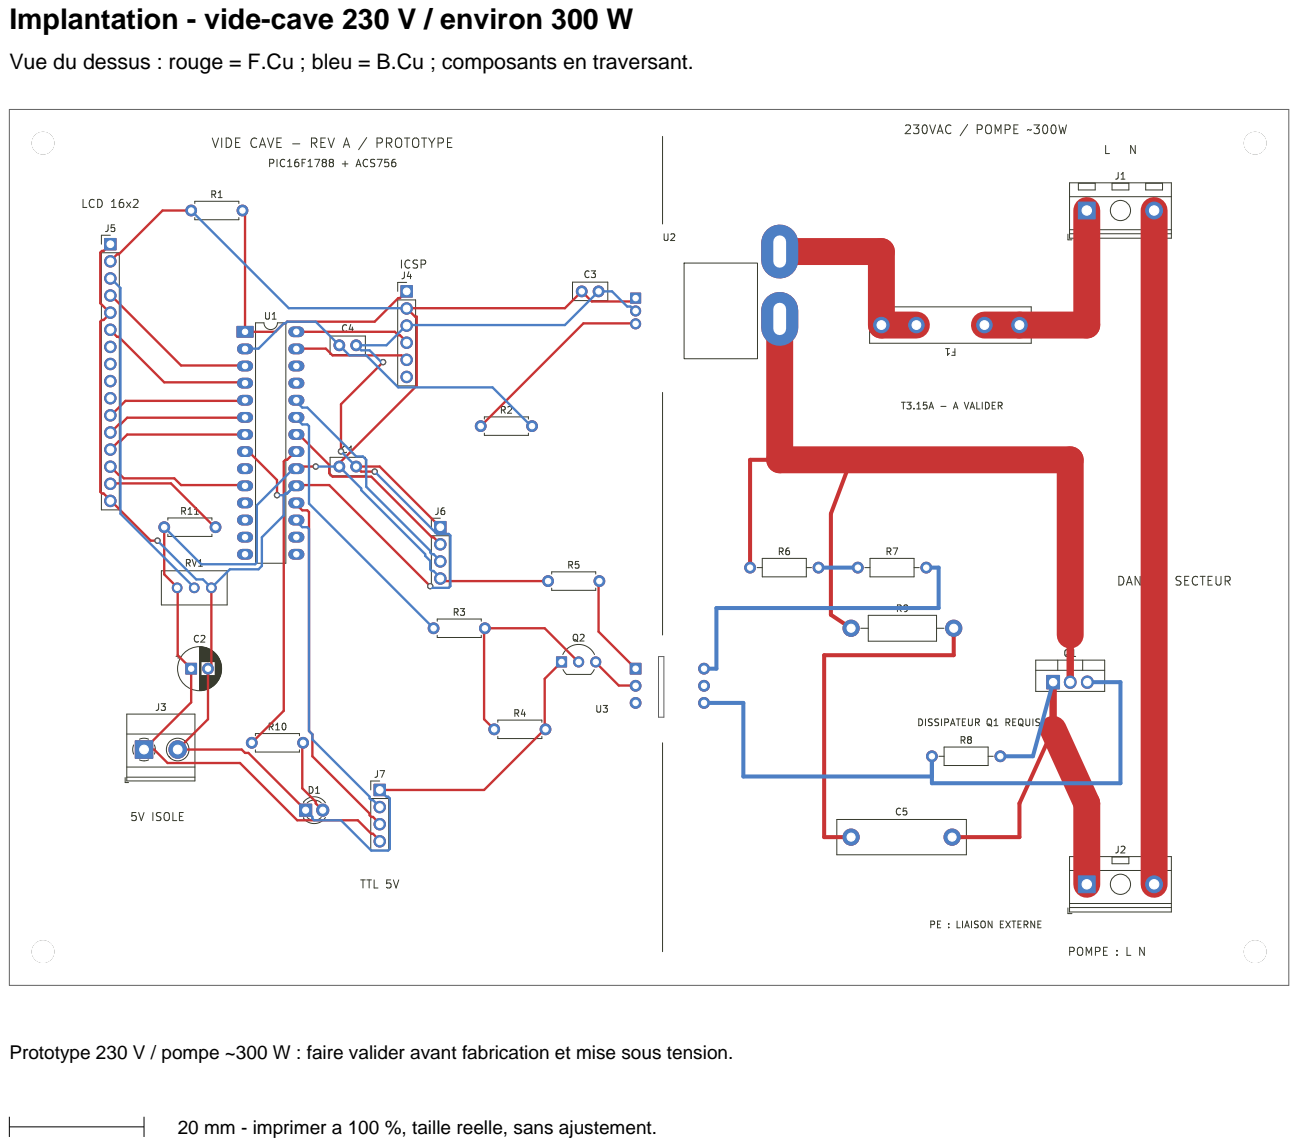
[picture p34: page 1]

Vue du dessus : rouge = F.Cu ; bleu = B.Cu ; composants en traversant.

DISSIPATEUR Q1 REQUIS VIDE CAVE - REV A / PROTOTYPE

PE : LIAISON EXTERNE TTL 5V

Prototype 230 V / pompe ~300 W : faire valider avant fabrication et mise sous tension.

20 mm - imprimer a 100 %, taille reelle, sans ajustement.
