glm02/projet-vide-cave/03_Electronique/Carte_vide_cave_PIC_Allegro_TRIAC/exports/typons/B_Cu_contact.pdf

## Typon face soudures B.Cu - contact

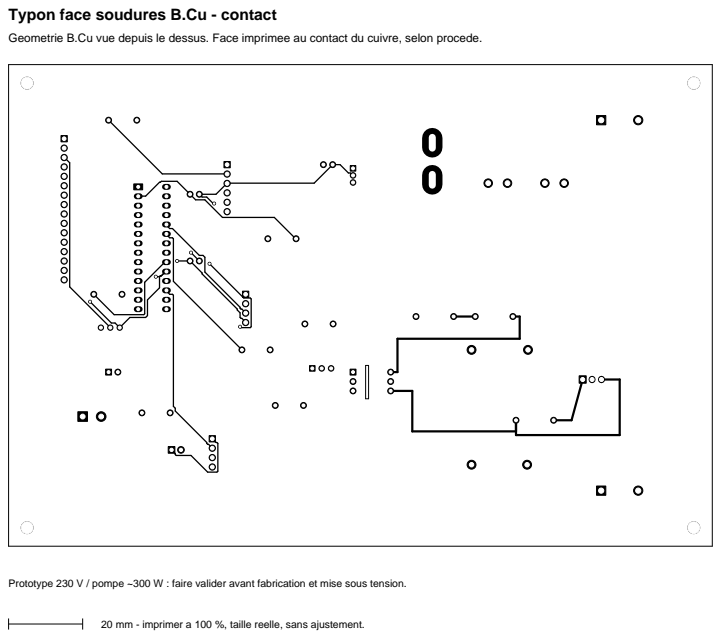
[picture p35: page 1]

Geometrie B.Cu vue depuis le dessus. Face imprimee au contact du cuivre, selon procede.

Prototype 230 V / pompe ~300 W : faire valider avant fabrication et mise sous tension.

20 mm - imprimer a 100 %, taille reelle, sans ajustement.
