glm02/projet-vide-cave/03_Electronique/Carte_vide_cave_PIC_Allegro_TRIAC/exports/typons/F_Cu_contact_miroir.pdf

## Typon face composants F.Cu - miroir

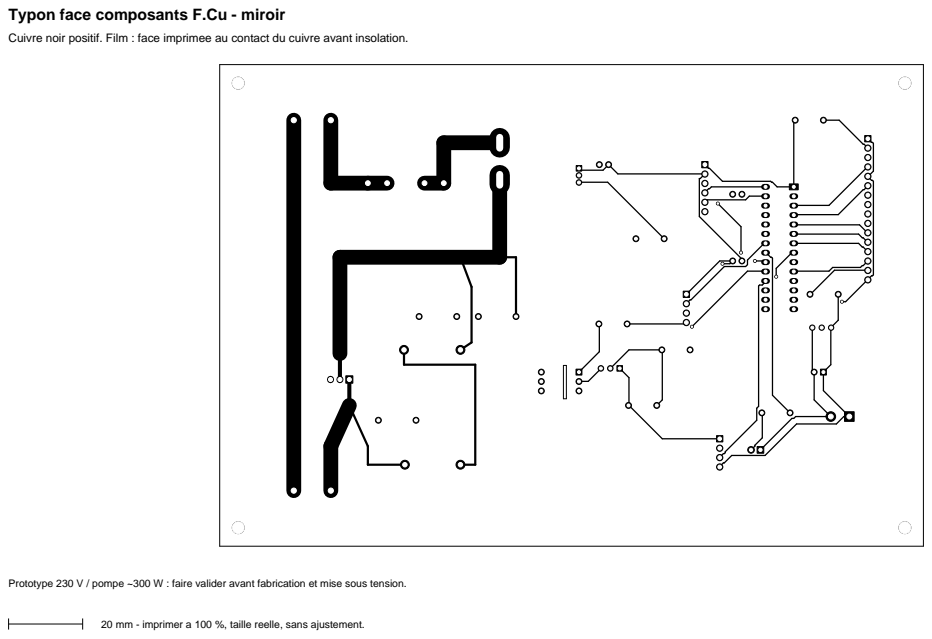
[picture p36: page 1]

Cuivre noir positif. Film : face imprimee au contact du cuivre avant insolation.

Prototype 230 V / pompe ~300 W : faire valider avant fabrication et mise sous tension.

20 mm - imprimer a 100 %, taille reelle, sans ajustement.
