glm02/projet-vide-cave/03_Electronique/Carte_vide_cave_PIC_Allegro_TRIAC/Vide_cave_5A.kicad_pcb

## KiCad design 03_Electronique/Carte_vide_cave_PIC_Allegro_TRIAC/Vide_cave_5A.kicad_pcb (2026-10-12)

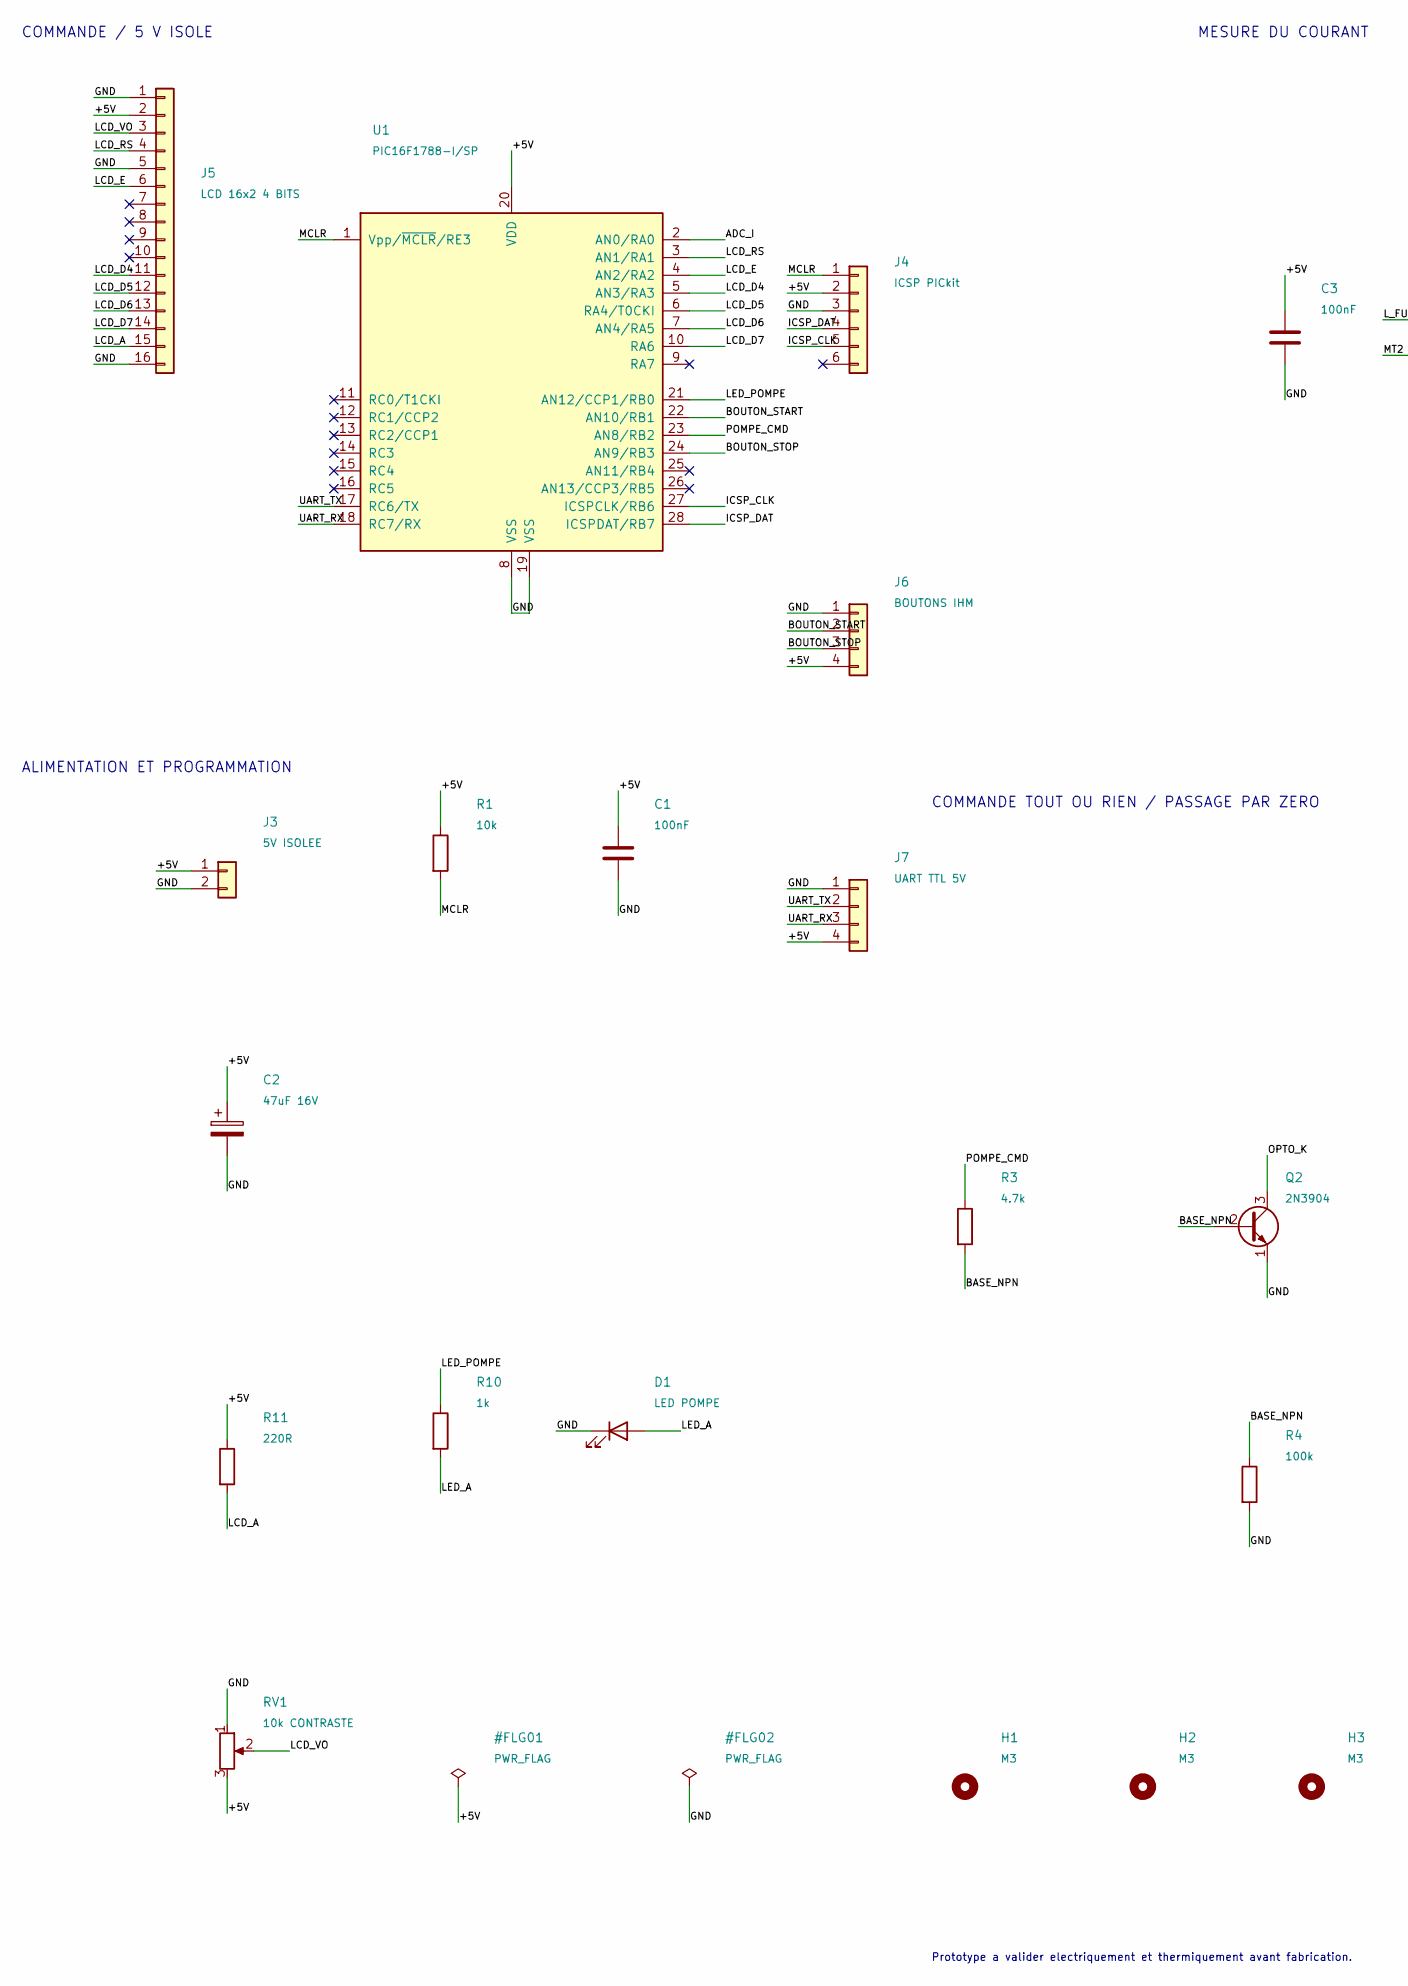
[picture p38: schematic Vide_cave_5A.kicad_sch, Vide-cave / PIC + ACS756 + TRIAC, part in row 1, column 1]

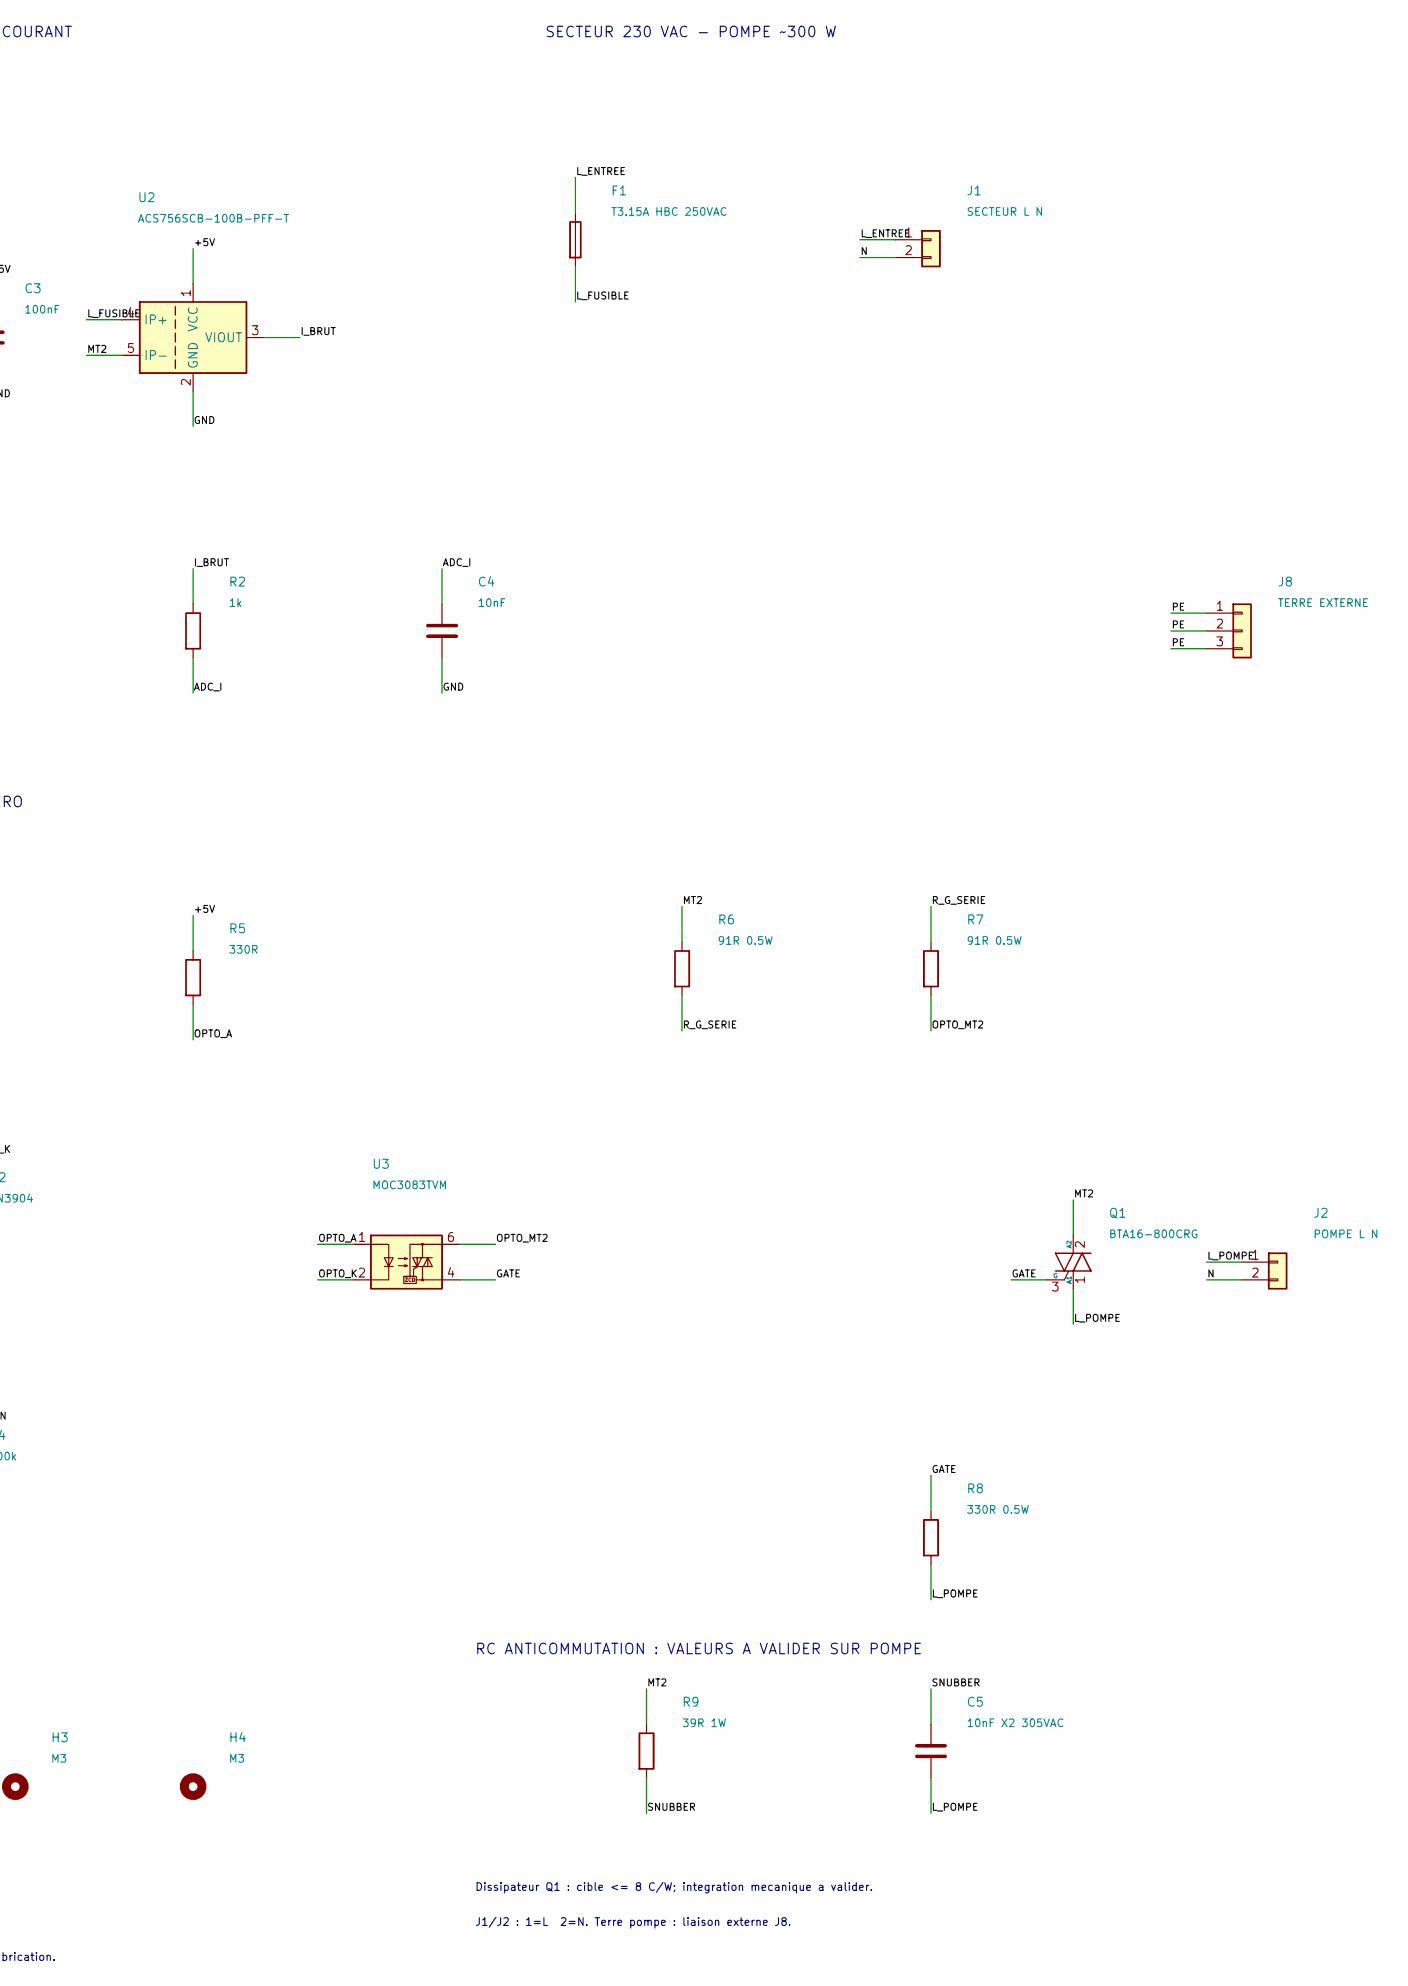
[picture p39: schematic Vide_cave_5A.kicad_sch, Vide-cave / PIC + ACS756 + TRIAC, part in row 1, column 2]

Parts:
C1, C3: 100nF; C_Disc_D5.0mm_W2.5mm_P2.50mm
C2: 47uF 16V; CP_Radial_D6.3mm_P2.50mm
C4: 10nF; C_Disc_D5.0mm_W2.5mm_P2.50mm
C5: 10nF X2 305VAC; C_Rect_L19.0mm_W5.0mm_P15.00mm_MKS4
D1: LED POMPE; LED_D3.0mm
F1: T3.15A HBC 250VAC; Fuseholder_Littelfuse_445_030_series_5x20mm
H1, H2, H3, H4: M3; MountingHole_3.2mm_M3
J1: SECTEUR L N; RND_205_00298_P10_drill1_4
J2: POMPE L N; RND_205_00298_P10_drill1_4
J3: 5V ISOLEE; TerminalBlock_Phoenix_MKDS-1,5-2_1x02_P5.00mm_Horizontal
J4: ICSP PICkit; PinHeader_1x06_P2.54mm_Vertical
J5: LCD 16x2 4 BITS; PinHeader_1x16_P2.54mm_Vertical
J6: BOUTONS IHM; PinHeader_1x04_P2.54mm_Vertical
J7: UART TTL 5V; PinHeader_1x04_P2.54mm_Vertical
J8: TERRE EXTERNE
Q1: BTA16-800CRG; TO-220-3_Vertical
Q2: 2N3904; TO-92_Inline_Wide
R1: 10k; R_Axial_DIN0207_L6.3mm_D2.5mm_P7.62mm_Horizontal
R2, R10: 1k; R_Axial_DIN0207_L6.3mm_D2.5mm_P7.62mm_Horizontal
R3: 4.7k; R_Axial_DIN0207_L6.3mm_D2.5mm_P7.62mm_Horizontal
R4: 100k; R_Axial_DIN0207_L6.3mm_D2.5mm_P7.62mm_Horizontal
R5: 330R; R_Axial_DIN0207_L6.3mm_D2.5mm_P7.62mm_Horizontal
R6, R7: 91R 0.5W; R_Axial_DIN0207_L6.3mm_D2.5mm_P10.16mm_Horizontal
R8: 330R 0.5W; R_Axial_DIN0207_L6.3mm_D2.5mm_P10.16mm_Horizontal
R9: 39R 1W; R_Axial_DIN0411_L9.9mm_D3.6mm_P15.24mm_Horizontal
R11: 220R; R_Axial_DIN0207_L6.3mm_D2.5mm_P7.62mm_Horizontal
RV1: 10k CONTRASTE; Potentiometer_Bourns_3296W_Vertical
U1: PIC16F1788-I/SP; DIP-28_W7.62mm_LongPads
U2: ACS756SCB-100B-PFF-T; ACS756_PFF
U3: MOC3083TVM; MOC3083TVM_slot

Connections:
/+5V: C1.1, C2.1, C3.1, J3.1, J4.2, J5.2, J6.4, J7.4, R1.1, R5.1, R11.1, RV1.3, U1.20 (VDD), U2.1 (VCC)
/ADC_I: C4.1, R2.2, U1.2 (AN0/RA0)
/BASE_NPN: Q2.2 (B), R3.2, R4.1
/BOUTON_START: J6.2, U1.22 (AN10/RB1)
/BOUTON_STOP: J6.3, U1.24 (AN9/RB3)
/GATE: Q1.3 (G), R8.1, U3.4
/GND: C1.2, C2.2, C3.2, C4.2, D1.1 (K), J3.2, J4.3, J5.1, J5.5, J5.16, J6.1, J7.1, Q2.1 (E), R4.2, RV1.1, U1.8 (VSS), U1.19 (VSS), U2.2 (GND)
/ICSP_CLK: J4.5, U1.27 (ICSPCLK/RB6)
/ICSP_DAT: J4.4, U1.28 (ICSPDAT/RB7)
/I_BRUT: R2.1, U2.3 (VIOUT)
/LCD_A: J5.15, R11.2
/LCD_D4: J5.11, U1.5 (AN3/RA3)
/LCD_D5: J5.12, U1.6 (RA4/T0CKI)
/LCD_D6: J5.13, U1.7 (AN4/RA5)
/LCD_D7: J5.14, U1.10 (RA6)
/LCD_E: J5.6, U1.4 (AN2/RA2)
/LCD_RS: J5.4, U1.3 (AN1/RA1)
/LCD_VO: J5.3, RV1.2
/LED_A: D1.2 (A), R10.2
/LED_POMPE: R10.1, U1.21 (AN12/CCP1/RB0)
/L_ENTREE: F1.1, J1.1
/L_FUSIBLE: F1.2, U2.4 (IP+)
/L_POMPE: C5.2, J2.1, Q1.1 (A1), R8.2
/MCLR: J4.1, R1.2, U1.1 (Vpp/~MCLR/RE3)
/MT2: Q1.2 (A2), R6.1, R9.1, U2.5 (IP-)
/N: J1.2, J2.2
/OPTO_A: R5.2, U3.1
/OPTO_K: Q2.3 (C), U3.2
/OPTO_MT2: R7.2, U3.6
/POMPE_CMD: R3.1, U1.23 (AN8/RB2)
/R_G_SERIE: R6.2, R7.1
/SNUBBER: C5.1, R9.2
/UART_RX: J7.3, U1.18 (RC7/RX)
/UART_TX: J7.2, U1.17 (RC6/TX)
unnamed: J8.1, J8.2, J8.3

Notes on the sheet:
COMMANDE / 5 V ISOLE
MESURE DU COURANT
SECTEUR 230 VAC - POMPE ~300 W
ALIMENTATION ET PROGRAMMATION
COMMANDE TOUT OU RIEN / PASSAGE PAR ZERO
RC ANTICOMMUTATION : VALEURS A VALIDER SUR POMPE
J1/J2 : 1=L 2=N. Terre pompe : liaison externe J8.
Dissipateur Q1 : cible <= 8 C/W; integration mecanique a valider.
Prototype a valider electriquement et thermiquement avant fabrication.

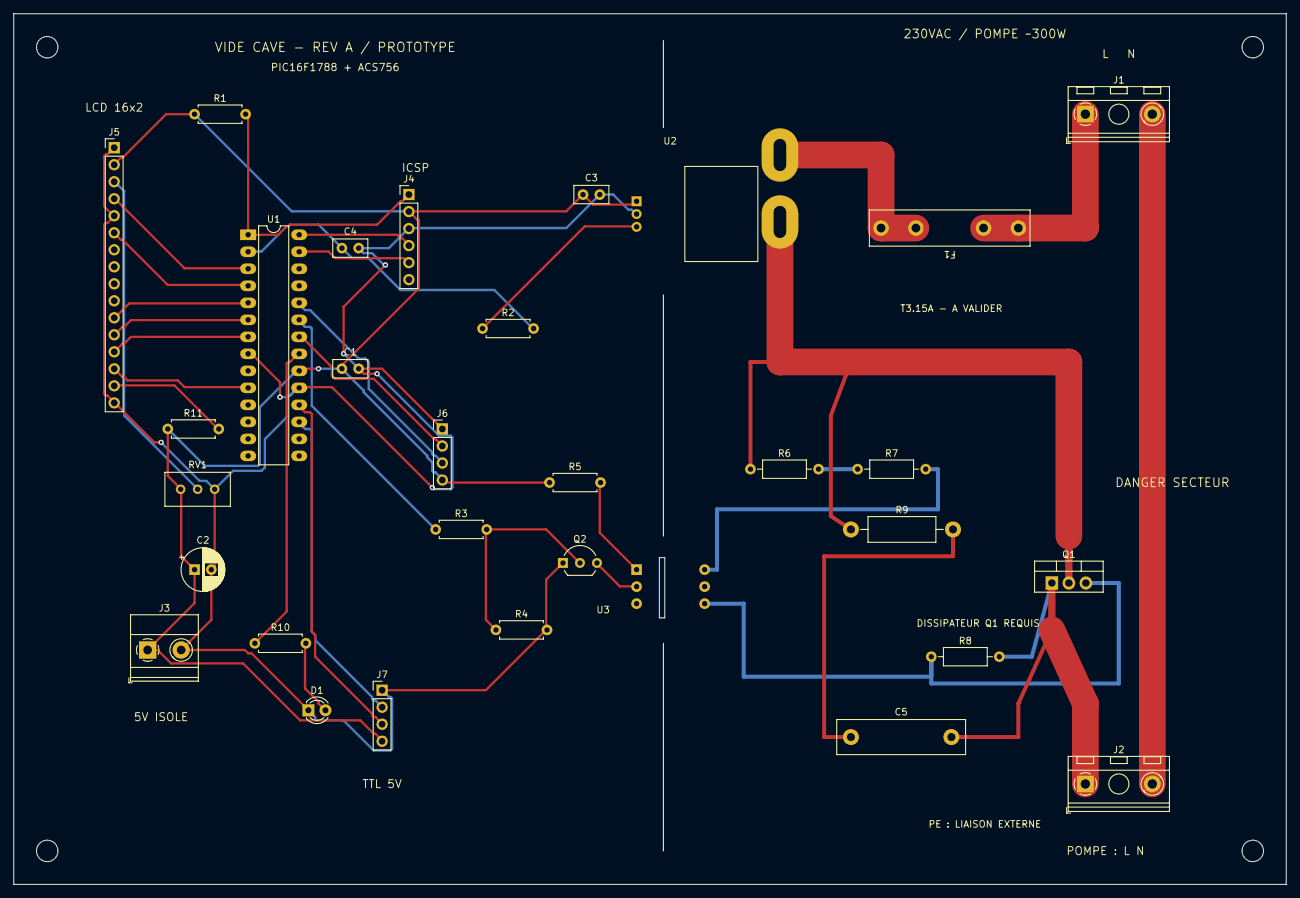
[picture p40: board Vide_cave_5A.kicad_pcb from above]

Board: 2 copper layers, 190.0 x 130.0 mm, 35 parts (0 on the bottom side), 34 nets.
