glm02/projet-vide-cave/03_Electronique/G206A_CAMEL_TP_CAO/G206_CAMEL_TP_CAO.kicad_pcb

## KiCad design 03_Electronique/G206A_CAMEL_TP_CAO/G206_CAMEL_TP_CAO.kicad_pcb (2026-10-12)

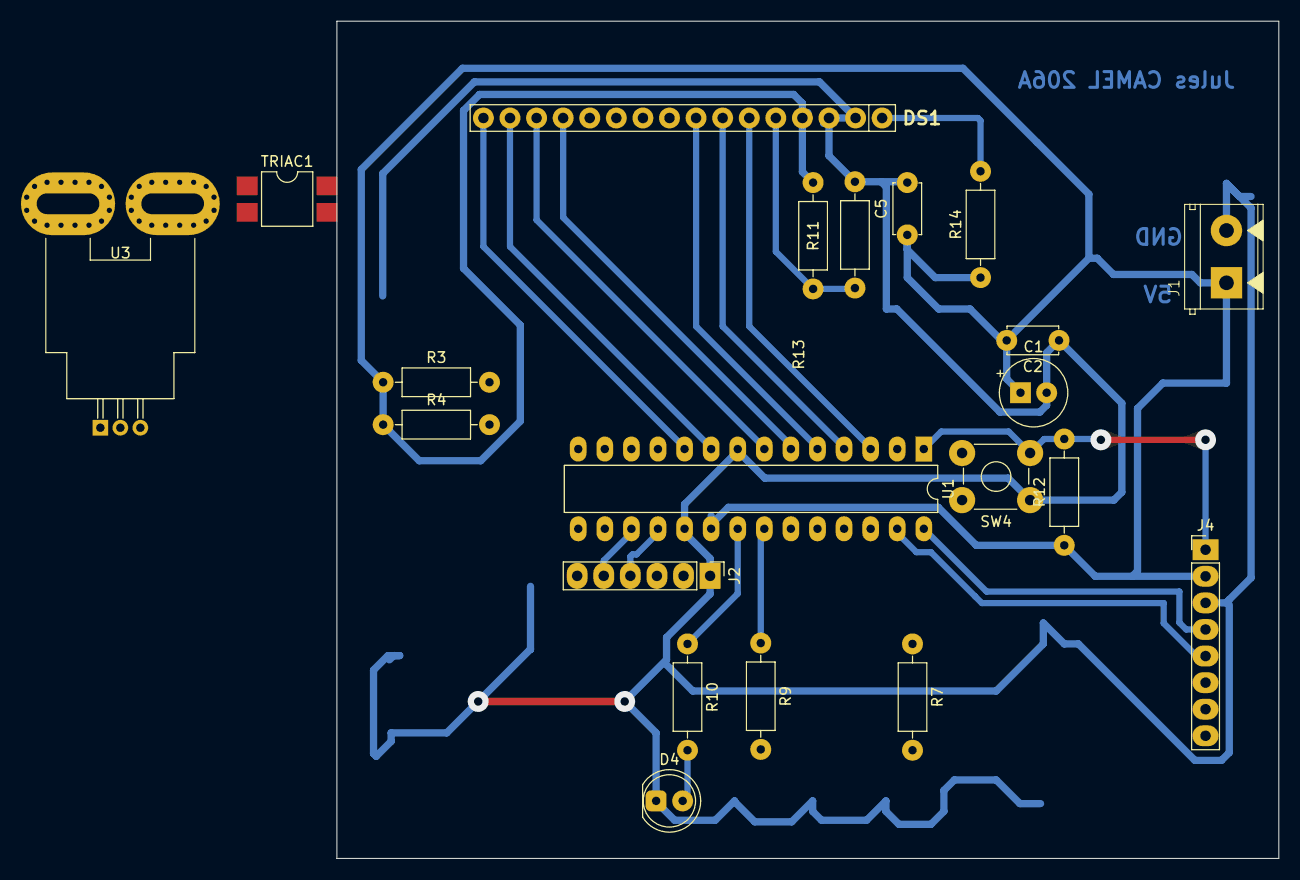
[picture p41: board G206_CAMEL_TP_CAO.kicad_pcb from above]

Board: 2 copper layers, 90.0 x 80.0 mm, 21 parts (0 on the bottom side), 19 nets.

Parts:
C1: 47uF; CP_Radial_D6.3mm_P2.50mm
C2, C5: 100n; C_Disc_D4.7mm_W2.5mm_P5.00mm
D4: LED R; LED_D5.0mm
DS1: 162B-CC_BC-3LP; 162B
J1: Alimentation; Bornier_1x02_L10mm_W7.5mm_P5mm
J2: Série (TTL); PinHeader_1x06_P2.54mm_Vertical
J4: Conn_PIC_ICSP_ICD; PicKit_4_Snap_1x08_P2.54mm_Vertical
R3, R4, R12: 10k; R_Axial_DIN0207_L6.3mm_D2.5mm_P10.16mm_Horizontal
R7, R9, R10, R14: 270; R_Axial_DIN0207_L6.3mm_D2.5mm_P10.16mm_Horizontal
R11: 56k; R_Axial_DIN0207_L6.3mm_D2.5mm_P10.16mm_Horizontal
R13: 1,5k; R_Axial_DIN0207_L6.3mm_D2.5mm_P10.16mm_Horizontal
SW4: B3F-1000; SW_TH_Tactile_Omron_B3F-10xx
TRIAC1: octo-triac; SMDIP-4_W7.62mm
U1: PIC16F1788-xSP; DIP-28_W7.62mm_LongPads
U3: Capteur de courant; Allegro_CB_PFF

Connections:
+5V: C1.1, C2.2, C5.1, DS1.4 (VDD), J1.1, J4.2 (VDD), R3.1, R4.1, R11.1, R12.1, R14.1, U1.20 (VDD), U3.1 (VCC)
GND: C1.2, C2.1, C5.2, D4.1 (K), DS1.2 (LEDK), DS1.3 (VSS), J1.2, J2.1, J4.3 (VSS), R13.2, SW4.1, TRIAC1.2, U1.8 (VSS), U1.19 (VSS), U3.2 (GND)
ICSPCLK: J4.5 (PGC/ICSPCLK), U1.27 (ICSPCLK/RB6)
ICSPDAT: J4.4 (PGD/ICSPDAT), U1.28 (ICSPDAT/RB7)
LCD_D4: DS1.13 (DB4), U1.6 (RA4/T0CKI)
LCD_D5: DS1.14 (DB5), U1.7 (AN4/RA5)
LCD_D6: DS1.15 (DB6), U1.9 (RA7)
LCD_D7: DS1.16 (DB7), U1.10 (RA6)
LCD_E: DS1.8 (E), U1.5 (AN3/RA3)
LCD_RS: DS1.6 (RS), U1.3 (AN1/RA1)
LCD_RW: DS1.7 (R/~W), U1.4 (AN2/RA2)
unnamed: D4.2 (A), R10.2
unnamed: DS1.1 (LEDA), R14.2
unnamed: DS1.5 (Vo), R11.2, R13.1
unnamed: R9.1, U1.22 (AN10/RB1)
unnamed: R10.1, U1.21 (AN12/CCP1/RB0)
uC_RXD_TTL: J2.4, U1.18 (RC7/RX)
uC_TXD_TTL: J2.5, U1.17 (RC6/TX)
~MCLR: J4.1 (~MCLR/VPP), R12.2, SW4.2, U1.1 (Vpp/~MCLR/RE3)
