glm02/projet-vide-cave/03_Electronique/Projets_KiCad_initiaux/PROJET VIDE CAVE/PROJET VIDE CAVE.kicad_sch

## KiCad design 03_Electronique/Projets_KiCad_initiaux/PROJET VIDE CAVE/PROJET VIDE CAVE.kicad_sch (2026-10-12)

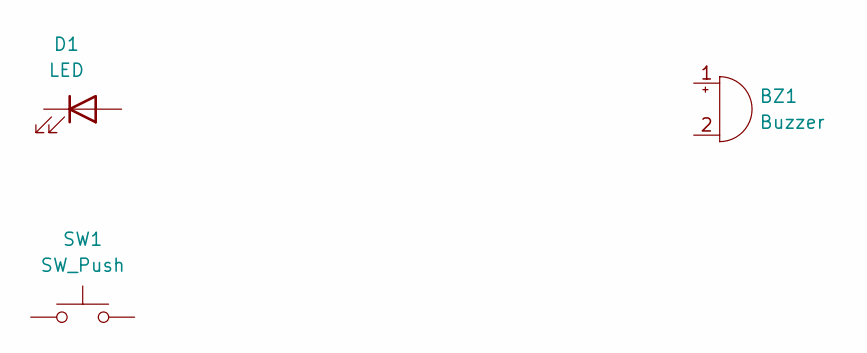
[picture p42: schematic PROJET VIDE CAVE.kicad_sch]

Parts:
BZ1: Buzzer
D1: LED
SW1: SW_Push
