glm02/projet-vide-cave/(commit log)

2026-10-12 Versionner les sources G206 nettoyées, les analyses et la visualisation Anatomy
2026-10-12 Enregistrer les dernières modifications du projet KiCad G206
2026-10-12 Ajouter étude MOC3041, simulations et guide de collaboration
2026-10-21 Synchro à deux en un double-clic : SYNC.bat, guide et notification Telegram
    Le collègue n'utilise pas Git : SYNC.bat enregistre ses modifs, récupère
    celles de l'autre puis envoie. En cas de modification simultanée du même
    fichier, on ne fusionne pas deux schémas KiCad (risque de fichier cassé) :
    sa version est mise de côté dans une branche sauvegarde-*. Les chemins
    longs sont activés car certaines empreintes dépassent 260 caractères, et
    un clone interrompu est réparé au lieu d'envoyer des suppressions.
    L'action Telegram reste inactive tant que les secrets ne sont pas posés.
2026-10-21 Retirer la notification Telegram, pas utilisée
    On se prévient de vive voix après chaque SYNC à la place.
2026-10-26 README : résumé illustré du projet en tête de page
    Pour qu'un visiteur comprenne le projet en dix secondes avant la partie
    technique (maquette Blender, vue de la carte, blocs fonctionnels, statut).
2026-11-04 Guide de préparation de la soutenance et du rapport de conception
    Applique les consignes IUT au projet : contenu de chaque partie du rapport,
    calculs déjà faits, corrections de schéma à mener, déroulé de l'oral,
    questions probables du jury et décisions encore à trancher.
2026-11-04 Diaporama de soutenance et brouillon du rapport de conception
    Diaporama de 11 diapos (déroulé à deux, notes de l'orateur) et rapport
    de conception structuré selon la consigne IUT, pré-rempli avec les
    calculs et choix du projet. Les points encore à décider sont signalés
    en rouge « À compléter » pour ne pas les présenter comme validés.
    Les scripts de génération sont gardés pour pouvoir refaire les fichiers.
2026-11-04 Partie programme réécrite dans le style du cours INFO3 GEII
    Retrait du calcul de valeur efficace (racine carrée, float : hors
    programme) au profit d'une mesure en points du CAN (max - min sur
    20 ms). Base de temps Timer2 10 ms sous IT qui lève seulement un flag,
    compteurs uint8_t dans le main, configuration MCC détaillée (ANSEL,
    TRIS, quantum, calcul de PR2) et squelette de programme à compléter.
2026-11-04 Base de temps : compteur lu en section critique au lieu d'un flag
    Un flag ne mémorise qu'une interruption : pendant les 20 ms de mesure,
    deux IT de 10 ms peuvent arriver et le comptage des trois jours
    prendrait du retard. L'IT incrémente Nb_10ms, le main le recopie et le
    remet à zéro avec les IT coupées. Précise aussi que les 1,3 A négligent
    le facteur de puissance. Corrections relevées dans la note 10.
2026-11-08 Diaporama aligné sur le vrai projet et fiche pour expliquer le code
    Le diaporama parlait du MOC3041 et d'un Timer2 alors que le projet utilise
    le MOC3023, le BTA12, le 6N136 et le code de main_simple.c (5 états, boucle
    de 100 ms, CAN lu sur 8 bits). Ajout de la nomenclature avec images, du
    code expliqué et du bilan fait / reste à faire. La fiche explique uint8_t,
    la lecture analogique et les 8 ou 12 bits pour l'oral.
2026-11-08 Consignes de soutenance et texte de l'oral dans Obsidian
    Rassemble en une note les consignes de l'IUT, la liste de ce qu'il faut
    montrer et un texte par partie, pour préparer l'oral sans diaporama.
2026-11-08 Gantt à jour, mesures RealTerm simplifiées et notes d'oral corrigées
    Le tableau de mesures ne garde que les valeurs lues et deux calculs simples.
    Le Gantt ajoute les tâches réellement faites, séance par séance : à relire,
    car le réel est estimé d'après les dates des fichiers et le prévisionnel
    reconstruit (le CSV ne garde pas les couleurs). Les composants sont présentés
    comme donnés par les profs.
2026-11-08 Explication ligne par ligne du code simplifié pour l'oral
    Le code passe à des fonctions simples, un seul compteur et sans macros
    do/while, pour pouvoir être expliqué ligne par ligne. Les notes d'oral
    renvoient vers cette version.
2026-11-08 Explication du code avec interruption Timer2
    Le code passe à une interruption Timer2 de 10 ms et à quatre états, écrits
    comme en cours, pour rester explicable par un débutant. Les notes d'oral
    sont alignées sur cette version.
2026-11-08 Texte des diapos pour la soutenance
    Rassemble en une note le texte à copier sur les diapos : cahier des charges,
    synoptique détaillé avec les signaux, essais, code, retards, améliorations
    et outils utilisés.
2026-11-08 Explication du 6N136 : schéma, branchement et code
    Le 6N136 n'étant pas encore relié sur le schéma, la note montre le montage
    prévu, le chronogramme et un code avec interruption IOC compilé mais pas
    testé, pour pouvoir l'expliquer à l'oral sans le présenter comme fait.
2026-11-08 Mémo sur la lecture analogique dans la note du code
    Rappelle que le CAN fait 12 bits et que le programme en garde 8, pour pouvoir
    l'expliquer simplement à l'oral.
2026-11-08 Note du code : version prévue avec MCC Classic
    L'équipe configure le Timer2 avec MCC Classic : la note indique ce qui change
    dans le code, sans le présenter comme testé avec les fichiers générés.
2026-11-08 Notes d'oral : Timer2 configuré dans MCC Classic
    Les notes montraient encore le réglage du Timer2 à la main, alors que
    l'équipe passe par MCC Classic. Le code à présenter utilise maintenant
    IT_Timer2, et ce qui n'est pas encore testé reste signalé.
2026-11-08 Notes d'oral : fin du passage au Timer2 dans MCC Classic
    Complète le commit précédent, arrêté avant les notes 25, 21 et 26 : texte des
    diapos, fiche d'oral et explication du 6N136.
2026-11-08 Notes d'oral : code simple en if/else et petits morceaux pour les diapos
    Le code passe à des if/else, sans switch ni static, parce qu'il doit pouvoir
    être expliqué par un débutant. La lecture analogique est expliquée à partir
    du potentiomètre et des valeurs relevées sous RealTerm.
2026-11-08 Notes d'oral : version courte du code, au format vu en cours
    Le programme passe à trois états et à une fonction d'interruption d'une ligne,
    appelée toutes les 100 ms par le Timer2 de MCC, comme dans les exemples du
    cours. Le code complet tient maintenant dans la note.
2026-11-08 Fiche mémo pour l'oral
    Rassemble sur une seule note ce qu'on peut dire : texte par partie, composants,
    chiffres, code, questions probables et phrases de secours.
